kyleburnsdev/icom-ctcss-board/firmware/README.md

# Arduino firmware

Firmware implementation has not started. The authoritative behavior draft is the [firmware specification](../docs/requirements/firmware-specification.md).

Create the Arduino sketch as `icom_ctcss/icom_ctcss.ino` so the sketch and folder names match. Document the board package, exact board selection, library versions, build and upload commands here when implemented. The target module is a 5 V / 16 MHz ATmega32U4 Pro Micro; the PCB pin assignments are fixed constraints.
