kyleburnsdev/icom-ctcss-board/mechanical/enclosure/README.md

# Enclosure

Open [icom-ctcss-enclosure.FCStd](icom-ctcss-enclosure.FCStd) in FreeCAD 1.1.1. P1 uses native Part Design bodies, constrained Sketcher profiles, Draft lettering and a Spreadsheet; no third-party workbench is required.

- [P1 design, views and verification](../../docs/implementation/enclosure-p1.md)
- [Primary 3MF build and assembly instructions](../../manufacturing/enclosure/README.md)
- [Requirements](../../docs/requirements/enclosure-specification.md)
- [Decision and prototype register](../../docs/requirements/enclosure-decision-register.md)
- [Reproducible builder](../../tools/build-enclosure.py)

The saved model retains installation coordinates. Print-oriented meshes are supporting assets beneath the primary build. `revisions/p01-enclosure.FCStd` preserves the previous native baseline.
