kyleburnsdev/icom-ctcss-board/manufacturing/pcb/digikey-board-parts.csv

DigiKey Part Number | Quantity | Customer Reference | Manufacturer Part Number | Manufacturer | Description
BC1084CT-ND | 4 | C1, C2, C4, C5 | K104K15X7RF5TL2 | Vishay | 100nF; 100nF 50V X7R 10%
399-5860-ND | 1 | C3 | R82DC4100AA60J | KEMET | 1uF 63V FILM; Nonpolar 1uF 63V 5%
495-1131-ND | 1 | C6 | B32522C0475J000 | TDK | 4.7uF 63V FILM; Nonpolar 4.7uF 63V 5%
732-5321-ND | 2 | J1, J2 | 61300811121 | Wurth Elektronik | 1x8 straight male header; 2.54 mm pitch
732-5318-ND | 1 | J3 | 61300511121 | Wurth Elektronik | 1x5 straight male header; 2.54 mm pitch
732-5317-ND | 2 | J4, J6 | 61300411121 | Wurth Elektronik | 1x4 straight male header; 2.54 mm pitch
732-5315-ND | 1 | J5 | 61300211121 | Wurth Elektronik | 1x2 straight male header; 2.54 mm pitch
2N3904TARCT-ND | 1 | Q1 | 2N3904TAR | onsemi | 2N3904TAR; Factory-formed CASE135AR
BC3934CT-ND | 2 | R1, R2 | MRS16000C3301FCT00 | Vishay | 3.3k; 1% metal film
BC3918CT-ND | 6 | R3, R9, R12, R13, R14, R15 | MRS16000C1002FCT00 | Vishay | 10k; 1% metal film
BC3915CT-ND | 2 | R4, R8 | MRS16000C1001FCT00 | Vishay | 1k; 1% metal film
BC3921CT-ND | 2 | R5, R11 | MRS16000C1003FCT00 | Vishay | 100k; 1% metal film
BC3933CT-ND | 2 | R6, R7 | MRS16000C3300FCT00 | Vishay | 330; 1% metal film
BC3940CT-ND | 1 | R10 | MRS16000C4701FCT00 | Vishay | 4.7k; 1% metal film
3296W-103LF-ND | 1 | RV1 | 3296W-1-103LF | Bourns | 10k 3296W; CW increases tone
732-5314-ND | 8 | TP1, TP2, TP3, TP4, TP5, TP6, TP7, TP8 | 61300111121 | Wurth Elektronik | Single 2.54 mm test post
732-61301211821-ND | 2 | U1 socket strips | 61301211821 | Wurth Elektronik | 1x12 female socket; 2.54 mm pitch; 2.5 mm body width; 8.5 mm insulator height
