kyleburnsdev/icom-ctcss-board/manufacturing/enclosure/supporting/revisions/p01/step/p0-enclosure-assembly.step

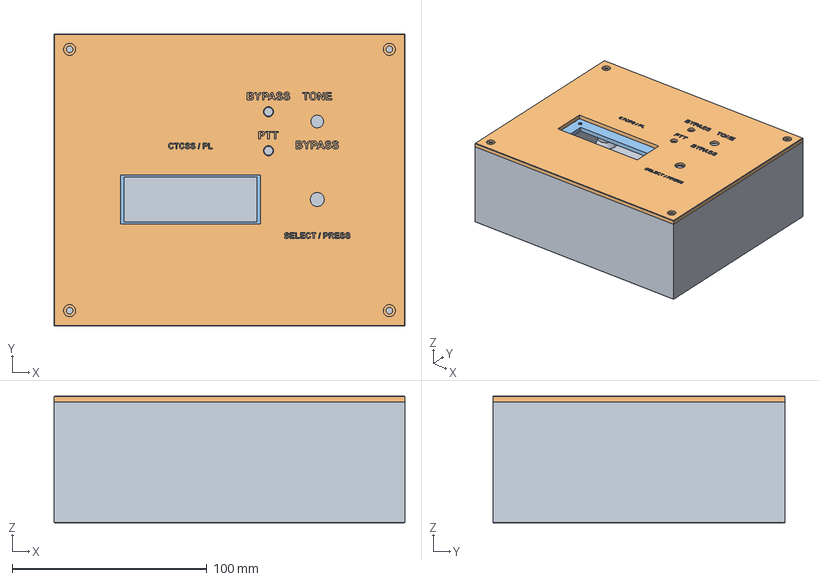
[picture p3: CAD file, 2026-10-22]
manufacturing/enclosure/supporting/revisions/p01/step/p0-enclosure-assembly.step
180.0 x 150.0 x 65.0 mm
P0 base â€” floor down001
P0 operator lid â€” exterior down001
LCD cradle001
LED keeper 001
LED keeper 002
