kyleburnsdev/icom-ctcss-board/manufacturing/enclosure/supporting/step/p1-enclosure-assembly.step

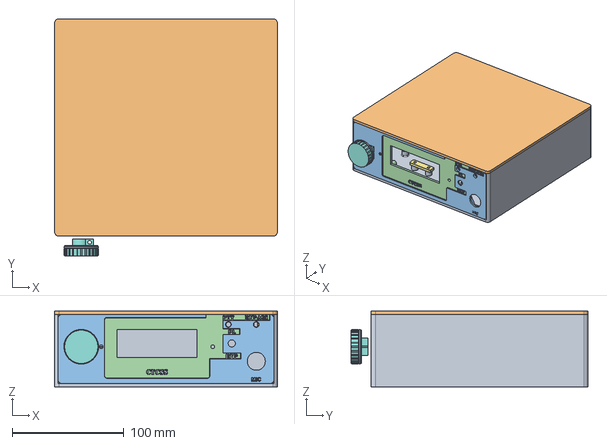
[picture p4: CAD file, 2026-10-22]
manufacturing/enclosure/supporting/step/p1-enclosure-assembly.step
200.0 x 213.0 x 68.0 mm
