kyleburnsdev/icom-ctcss-board/manufacturing/enclosure/p1-enclosure.3mf

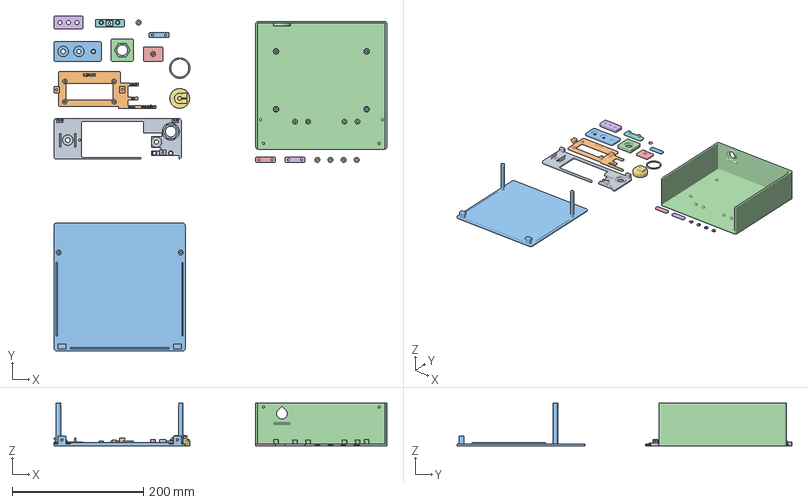
[picture p5: CAD file, 2026-10-22]
manufacturing/enclosure/p1-enclosure.3mf
507.2 x 510.2 x 65.0 mm
fascia_1
displayinsert_1
controlcoupon_1
gxcoupon_1
mountcoupon_1
shaftcoupon_1
encoderknob_1
ledkeeper_1
knobaccentring_1
pcbwasher-fit_1
wirekeeper-fit_1
base_1
wirekeeper-a_1
wirekeeper-b_1
pcbwasher-a_1
pcbwasher-b_1
pcbwasher-c_1
pcbwasher-d_1
cover_1
