kyleburnsdev/icom-ctcss-board/manufacturing/enclosure/supporting/revisions/p01/p01-enclosure.3mf

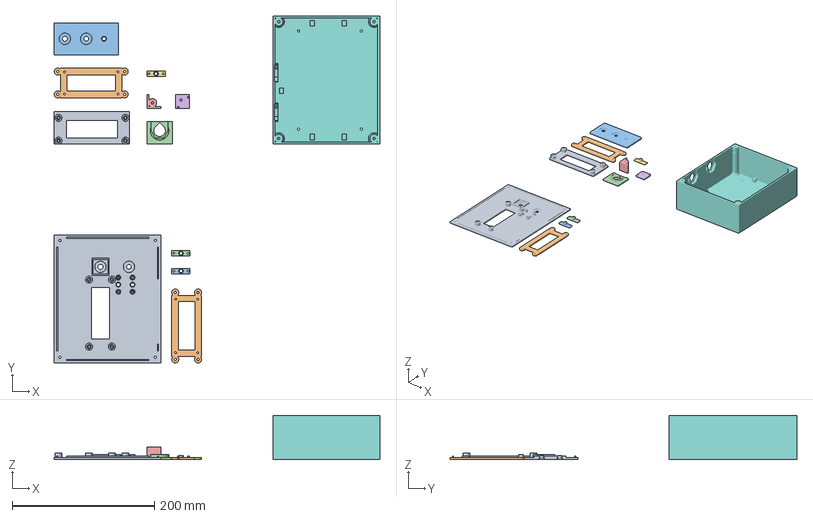
[picture p6: CAD file, 2026-10-22]
manufacturing/enclosure/supporting/revisions/p01/p01-enclosure.3mf
457.2 x 487.2 x 62.0 mm
lcdcoupon_1
lcdcradle_1 x 2
controlcoupon_1
gxcoupon_1
jointbasecoupon_1
jointlidcoupon_1
ledkeeper1_1 x 2
base_1
lid_1
ledkeeper2_1
