kyleburnsdev/icom-ctcss-board/manufacturing/enclosure/supporting/revisions/p01/stl/p0-lid.stl

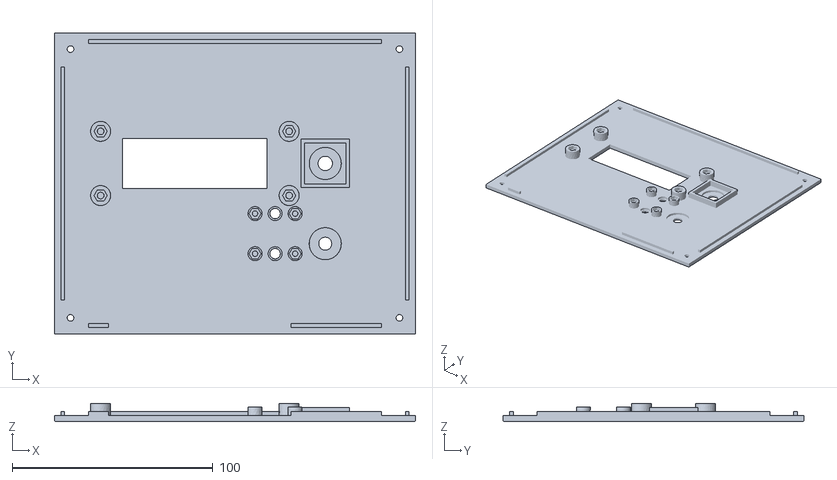
[picture p7: CAD file, 2026-10-22]
manufacturing/enclosure/supporting/revisions/p01/stl/p0-lid.stl
180.0 x 150.0 x 9.00
