kyleburnsdev/icom-ctcss-board/manufacturing/enclosure/supporting/stl/p1-wirekeeper.stl

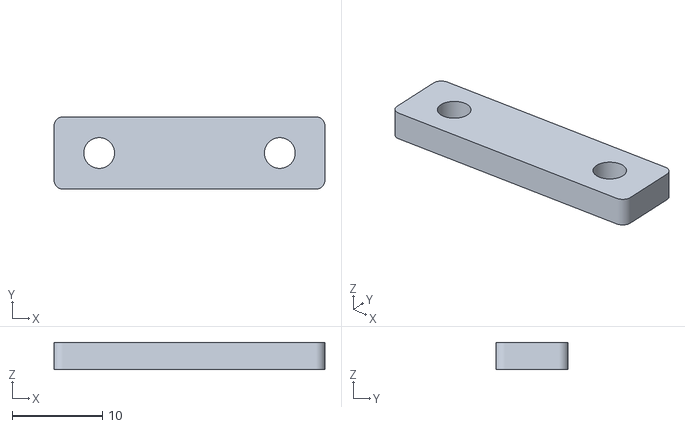
[picture p8: CAD file, 2026-10-22]
manufacturing/enclosure/supporting/stl/p1-wirekeeper.stl
30.0 x 8.00 x 3.00
