kyleburnsdev/icom-ctcss-board/mechanical/enclosure/icom-ctcss-enclosure.FCStd

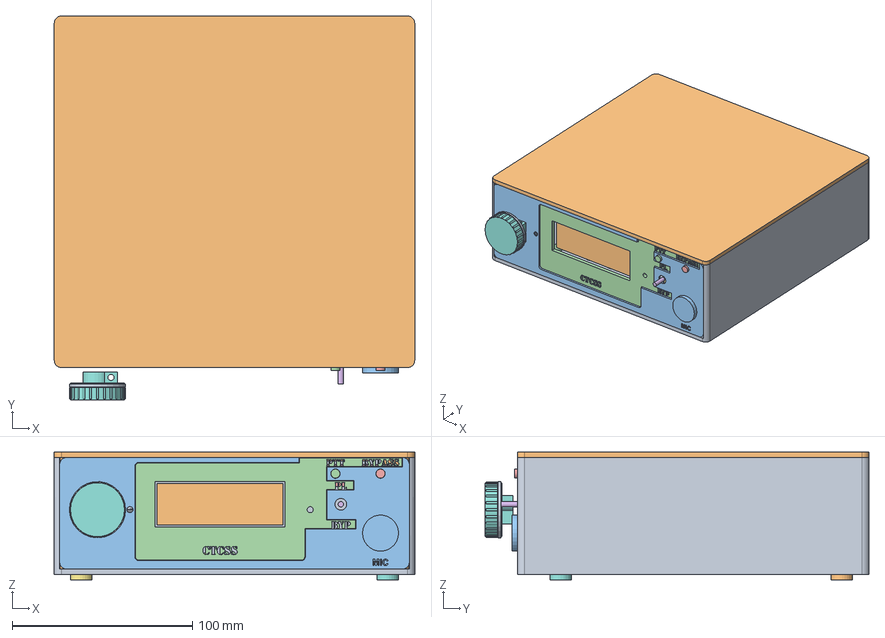
[picture p9: CAD file, 2026-10-22]
mechanical/enclosure/icom-ctcss-enclosure.FCStd
200.0 x 213.0 x 71.0 mm
Base
Cover
Fascia
DisplayInsert
LedKeeper
PcbWasher x 4
WireKeeper x 2
EncoderKnob
KnobAccentRing
VisibleLcdGlass
MicShell
PttLens
BypassLens
BypassLever
CompliantFoot1
CompliantFoot2
CompliantFoot3
CompliantFoot4
