kyleburnsdev/icom-ctcss-board/mechanical/enclosure/revisions/p01-enclosure.FCStd

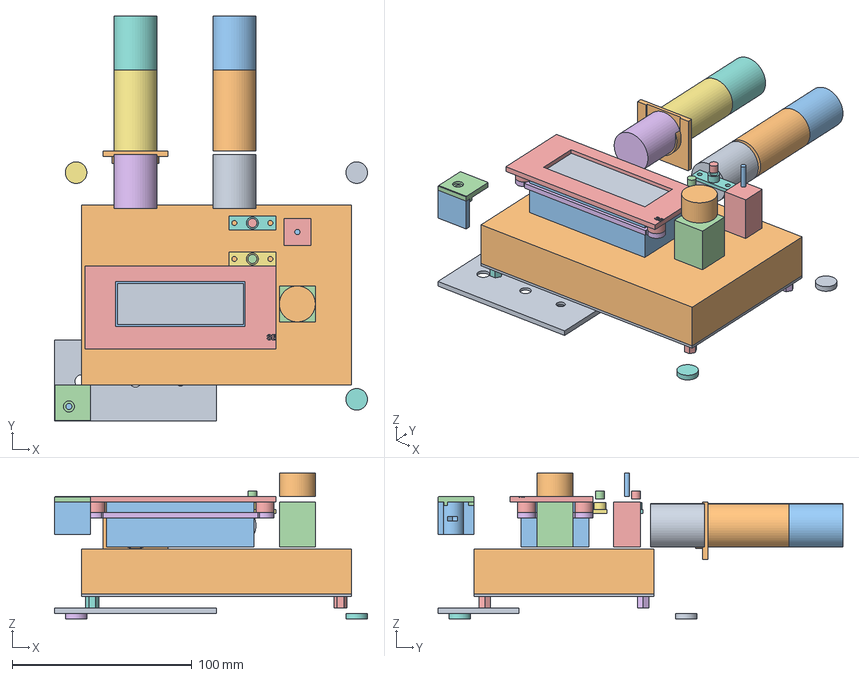
[picture p10: CAD file, 2026-10-22]
mechanical/enclosure/revisions/p01-enclosure.FCStd
174.0 x 225.0 x 81.0 mm
ControlCoupon001
GXCoupon001
JointBaseCoupon001
JointLidCoupon001
LCDCoupon001
LCD cradle001
LED keeper 001
LED keeper 002
Carrier PCB â€” existing hole pattern
Populated carrier allocation
LCD/backpack allocation
EC11 allocation
Toggle allocation
GX16 internal termination allocation
GX16 mating plug envelope
GX16 cable bend allocation
GX16 internal termination allocation001
GX16 mating plug envelope001
GX16 cable bend allocation001
Socketed Pro Micro module
Purchased insulating standoff
Purchased insulating standoff001
Purchased insulating standoff002
Purchased insulating standoff003
LCD viewing surface
Encoder knob
Bypass lever
5 mm indicator lens
5 mm indicator lens001
Nonslip foot
Nonslip foot001
Nonslip foot002
Nonslip foot003
