kyleburnsdev/icom-ctcss-board/mechanical/pcb/icom-ctcss-pcb-cam.FCStd

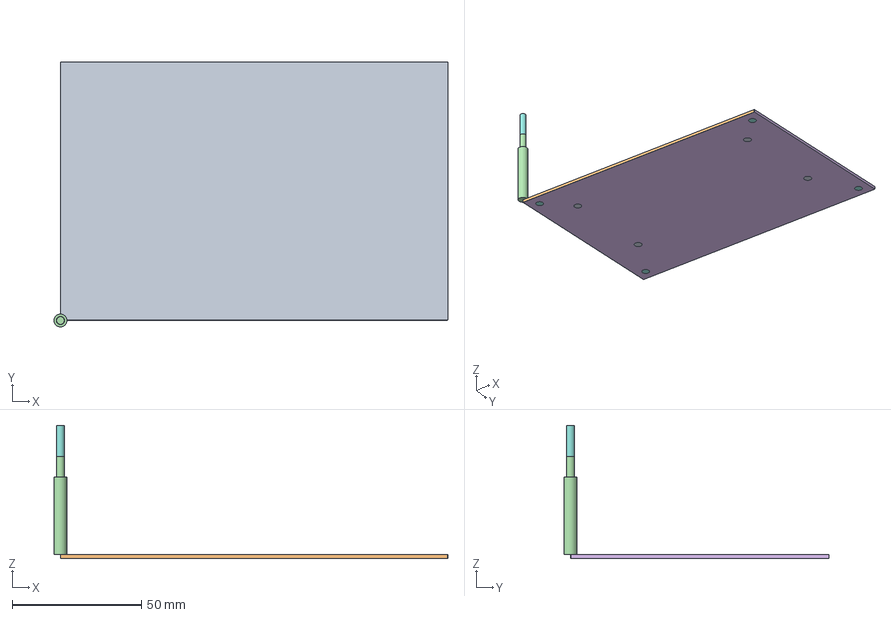
[picture p11: CAD file, 2026-10-31]
mechanical/pcb/icom-ctcss-pcb-cam.FCStd
152.6 x 102.6 x 51.7 mm
Endmill001
Endmill006
Endmill009
Endmill018
Endmill021
Model-Job00_RegistrationPreparation | 150 x 100 x 1.5 mm blank, top Z0
Model-Job10_BottomCopper | 150 x 100 x 1.5 mm blank, top Z0
Model-Job30_BottomHoles | 150 x 100 x 1.5 mm blank, top Z0
Model-Job40_TopLegend | 150 x 100 x 1.5 mm blank, top Z0
Model-Job20_BottomMaskRemoval | 150 x 100 x 1.5 mm blank, top Z0
T3 Corn 0.8 mm
T3 Corn 0.8 | 0.9 mm bore feed
T3 Corn 0.8 | 1.1 mm bore feed
T3 Corn 0.8 | enclosure mounts
Laser focus placeholder | no spindle post
PocketFourEnclosureMounts_Floors
PrepareFourJigHoles_Floors
Stock
Stock001
Stock002
Stock003
Stock004
T2 V-bit 30 deg tip 0.2 mm
T4 Makera spring solder-mask remover | 0.3 mm 30 deg
