kyleburnsdev/icom-ctcss-board/manufacturing/enclosure/supporting/revisions/p01/stl/p0-lcdcradle.stl

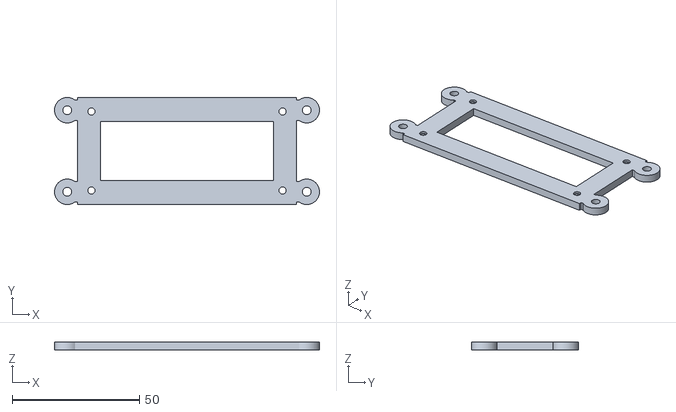
[picture p12: CAD file, 2026-10-22]
manufacturing/enclosure/supporting/revisions/p01/stl/p0-lcdcradle.stl
104.0 x 42.0 x 3.00
