kyleburnsdev/icom-ctcss-board/manufacturing/enclosure/supporting/stl/p1-controlcoupon.stl

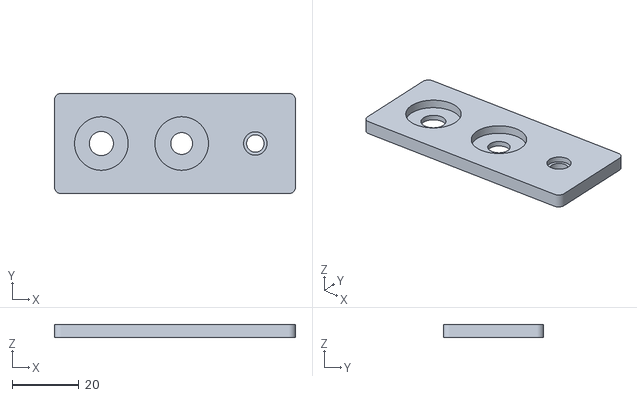
[picture p13: CAD file, 2026-10-22]
manufacturing/enclosure/supporting/stl/p1-controlcoupon.stl
72.0 x 30.0 x 4.00
