kyleburnsdev/icom-ctcss-board/manufacturing/enclosure/supporting/revisions/p01/stl/p0-ledkeeper2.stl

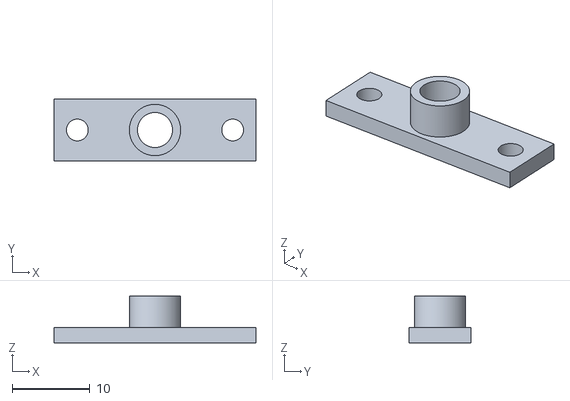
[picture p14: CAD file, 2026-10-22]
manufacturing/enclosure/supporting/revisions/p01/stl/p0-ledkeeper2.stl
26.0 x 8.00 x 6.00
