kyleburnsdev/icom-ctcss-board/manufacturing/enclosure/supporting/stl/p1-base.stl

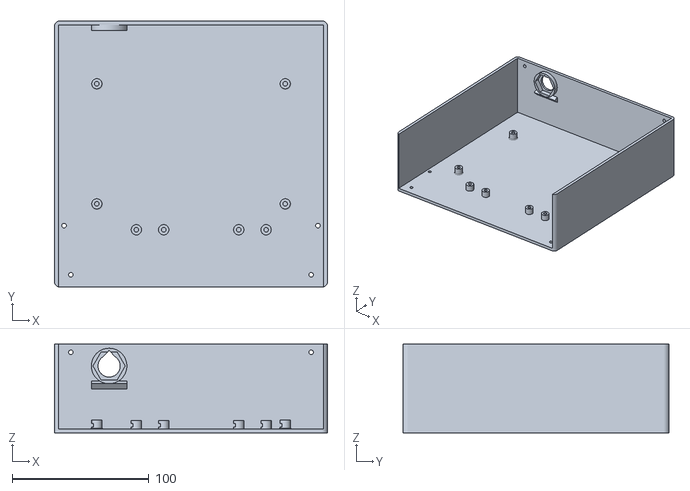
[picture p15: CAD file, 2026-10-22]
manufacturing/enclosure/supporting/stl/p1-base.stl
200.0 x 195.0 x 65.0
