kyleburnsdev/icom-ctcss-board/manufacturing/enclosure/supporting/revisions/p01/stl/p0-jointlidcoupon.stl

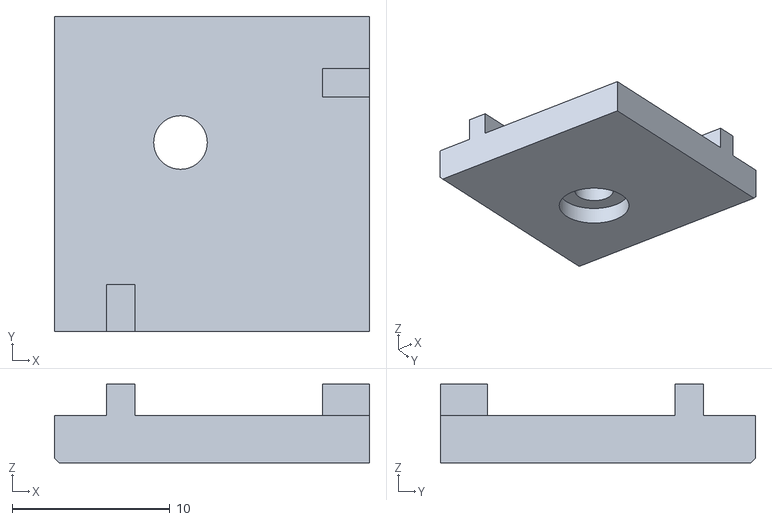
[picture p16: CAD file, 2026-10-22]
manufacturing/enclosure/supporting/revisions/p01/stl/p0-jointlidcoupon.stl
20.0 x 20.0 x 5.00
