kyleburnsdev/icom-ctcss-board/manufacturing/enclosure/supporting/stl/p1-displayinsert.stl

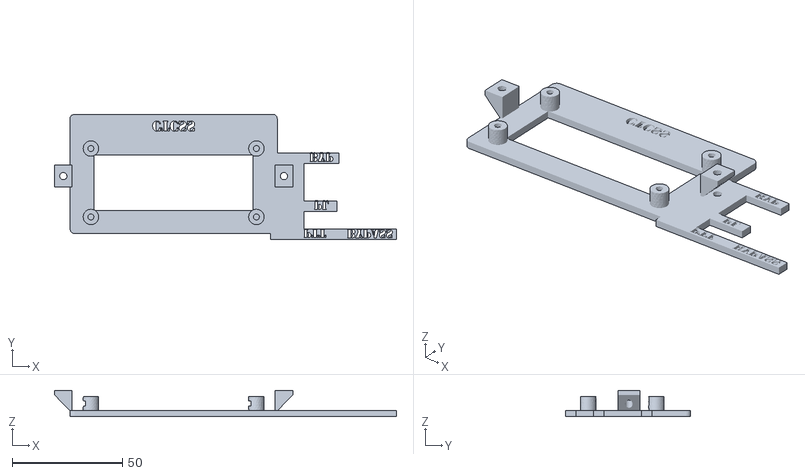
[picture p17: CAD file, 2026-10-22]
manufacturing/enclosure/supporting/stl/p1-displayinsert.stl
155.0 x 56.8 x 11.8
