kyleburnsdev/icom-ctcss-board/manufacturing/enclosure/supporting/revisions/p01/stl/p0-jointbasecoupon.stl

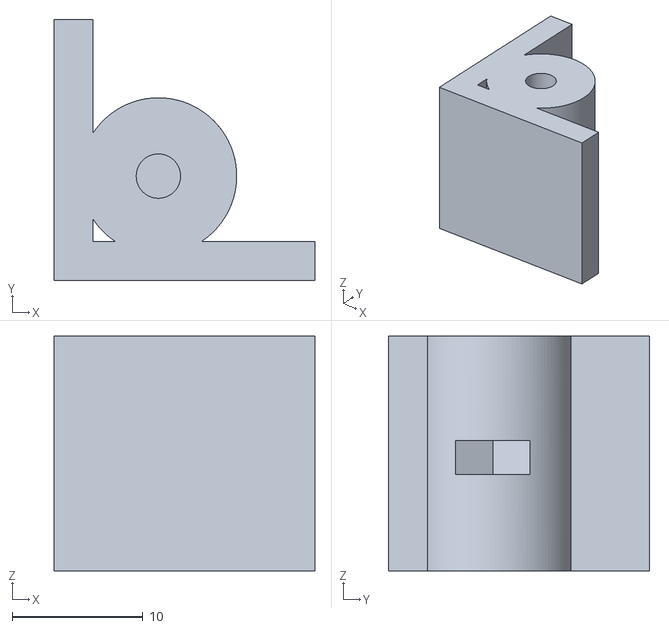
[picture p18: CAD file, 2026-10-22]
manufacturing/enclosure/supporting/revisions/p01/stl/p0-jointbasecoupon.stl
20.0 x 20.0 x 18.0
