kyleburnsdev/icom-ctcss-board/manufacturing/enclosure/supporting/stl/p1-fascia.stl

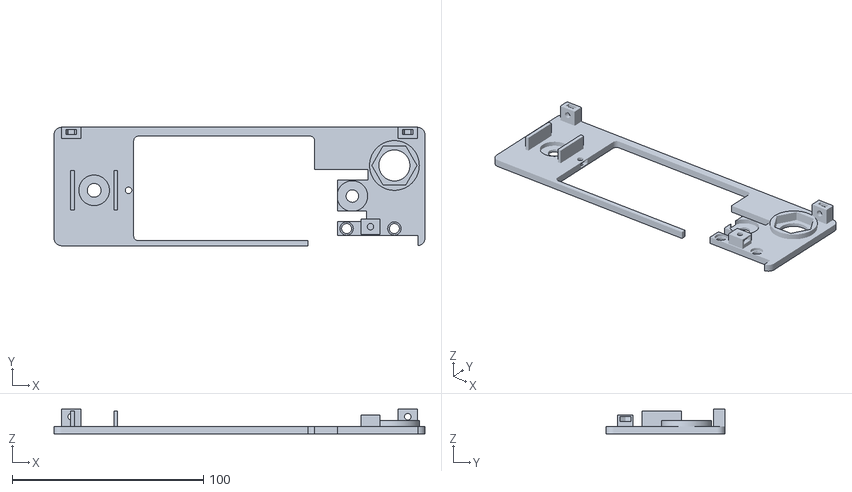
[picture p19: CAD file, 2026-10-22]
manufacturing/enclosure/supporting/stl/p1-fascia.stl
194.0 x 62.0 x 13.0
