kyleburnsdev/icom-ctcss-board/manufacturing/enclosure/supporting/revisions/p01/stl/p0-gxcoupon.stl

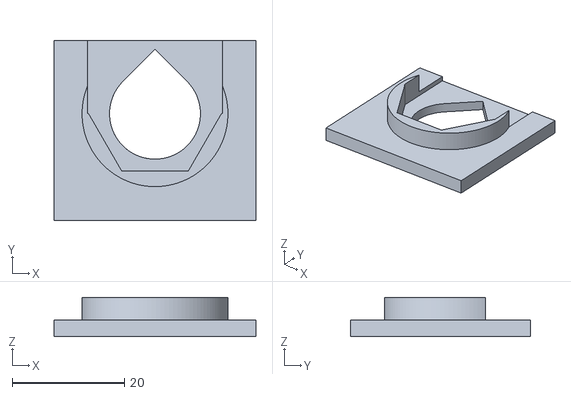
[picture p20: CAD file, 2026-10-22]
manufacturing/enclosure/supporting/revisions/p01/stl/p0-gxcoupon.stl
36.0 x 32.0 x 7.00
