kyleburnsdev/icom-ctcss-board/manufacturing/enclosure/supporting/stl/p1-knobaccentring.stl

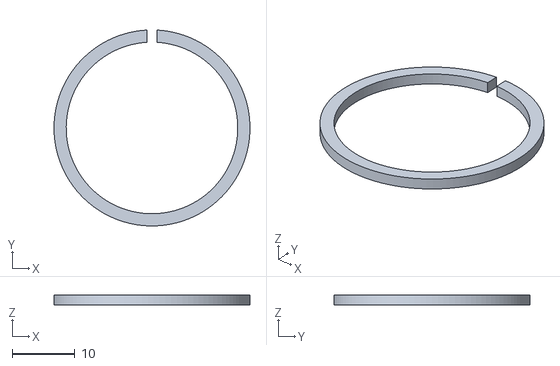
[picture p21: CAD file, 2026-10-22]
manufacturing/enclosure/supporting/stl/p1-knobaccentring.stl
31.2 x 31.2 x 1.60
