kyleburnsdev/icom-ctcss-board/manufacturing/enclosure/supporting/stl/p1-shaftcoupon.stl

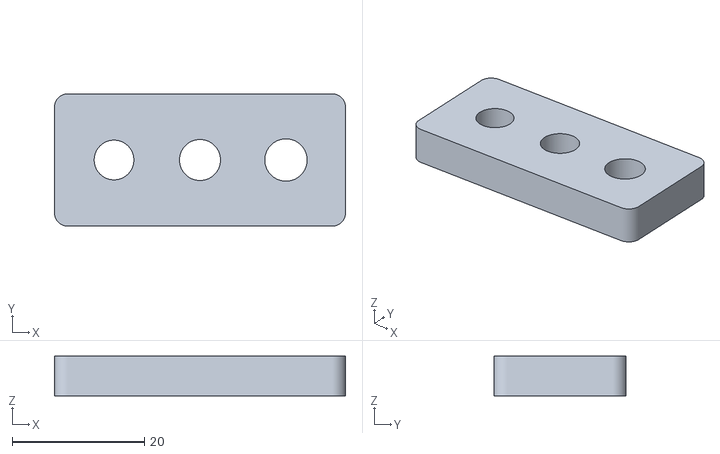
[picture p22: CAD file, 2026-10-22]
manufacturing/enclosure/supporting/stl/p1-shaftcoupon.stl
44.0 x 20.0 x 6.00
