kyleburnsdev/icom-ctcss-board/manufacturing/enclosure/supporting/revisions/p01/stl/p0-lcdcoupon.stl

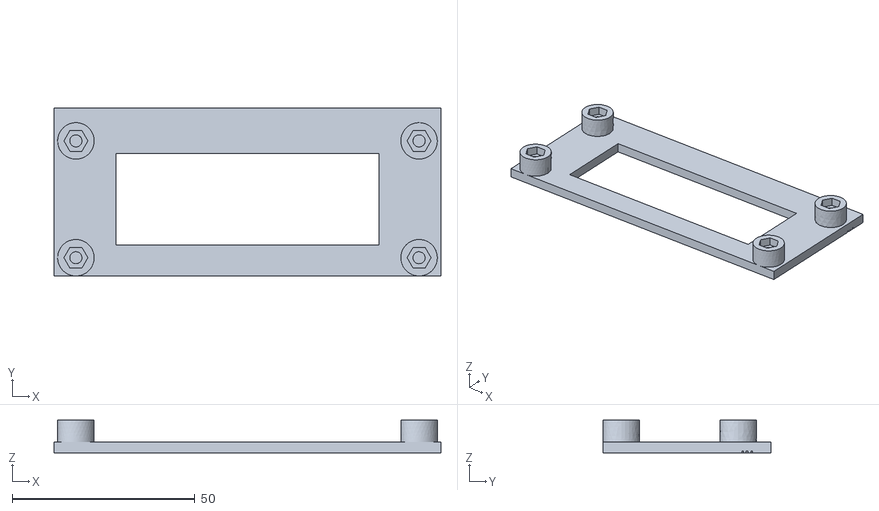
[picture p23: CAD file, 2026-10-22]
manufacturing/enclosure/supporting/revisions/p01/stl/p0-lcdcoupon.stl
106.0 x 46.0 x 9.00
