kyleburnsdev/icom-ctcss-board/manufacturing/enclosure/supporting/stl/p1-gxcoupon.stl

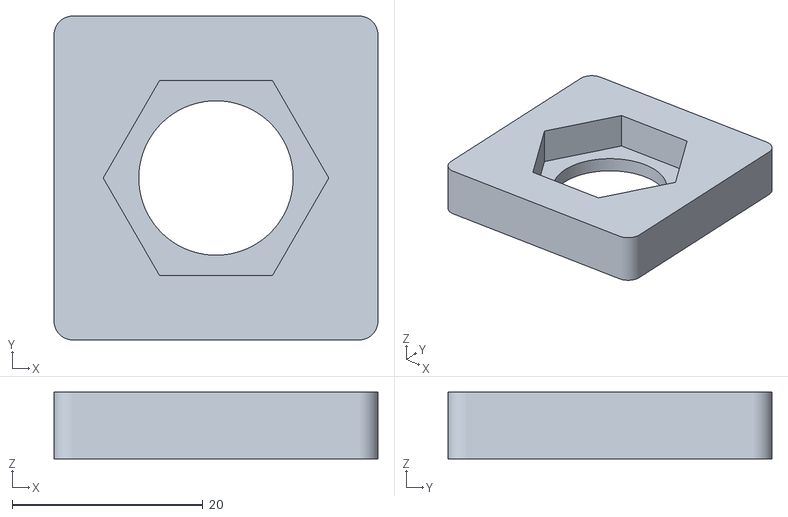
[picture p24: CAD file, 2026-10-22]
manufacturing/enclosure/supporting/stl/p1-gxcoupon.stl
34.0 x 34.0 x 7.00
