kyleburnsdev/icom-ctcss-board/manufacturing/enclosure/supporting/revisions/p01/stl/p0-controlcoupon.stl

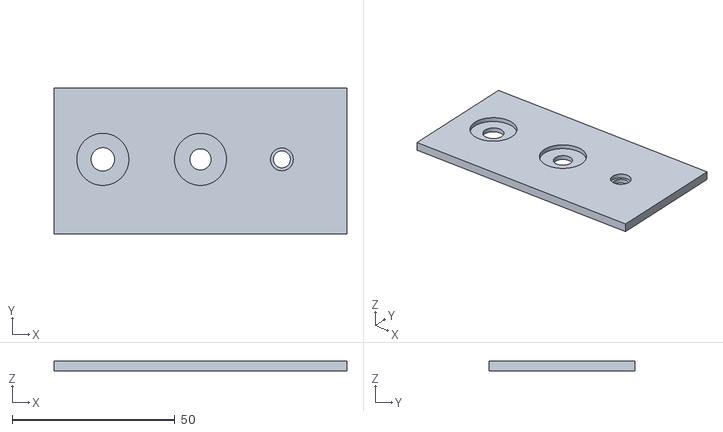
[picture p25: CAD file, 2026-10-22]
manufacturing/enclosure/supporting/revisions/p01/stl/p0-controlcoupon.stl
90.0 x 45.0 x 3.00
