kyleburnsdev/icom-ctcss-board/manufacturing/enclosure/supporting/stl/p1-encoderknob.stl

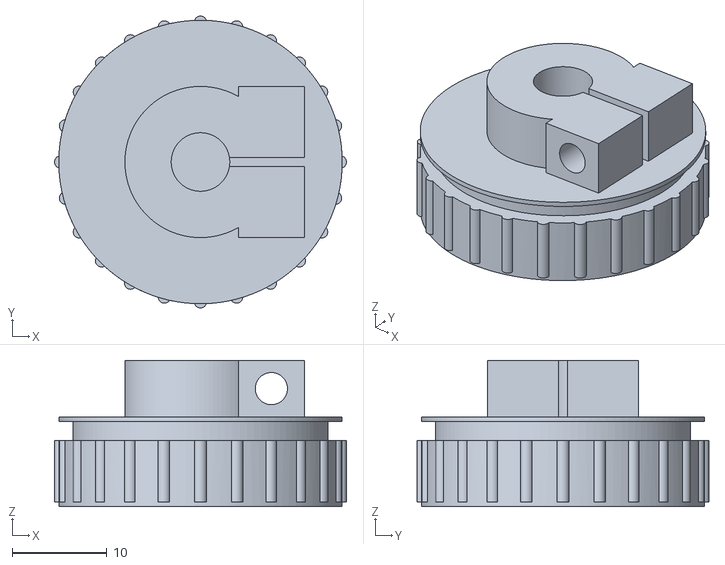
[picture p26: CAD file, 2026-10-22]
manufacturing/enclosure/supporting/stl/p1-encoderknob.stl
30.9 x 30.9 x 15.5
