kyleburnsdev/icom-ctcss-board/manufacturing/enclosure/supporting/revisions/p01/stl/p0-base.stl

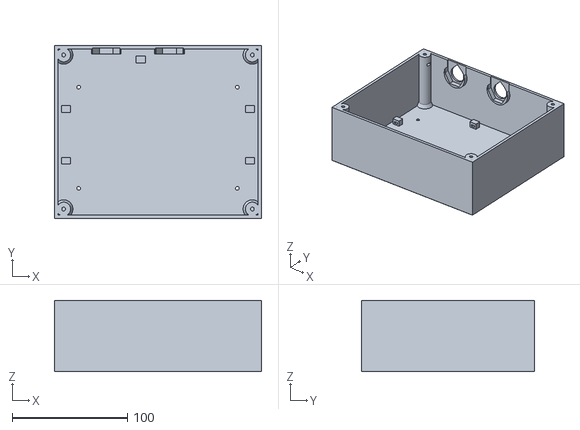
[picture p27: CAD file, 2026-10-22]
manufacturing/enclosure/supporting/revisions/p01/stl/p0-base.stl
180.0 x 150.0 x 62.0
