kyleburnsdev/icom-ctcss-board/manufacturing/enclosure/supporting/stl/p1-mountcoupon.stl

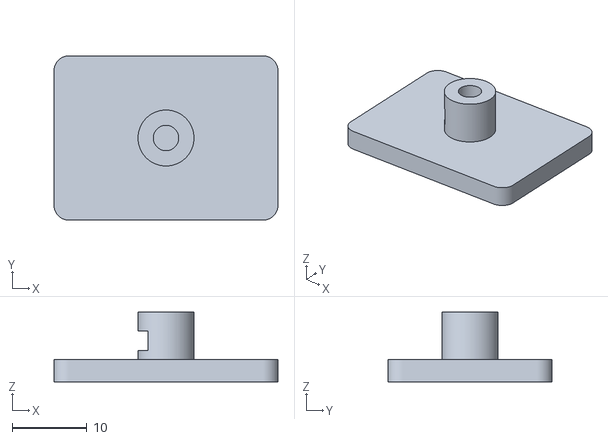
[picture p28: CAD file, 2026-10-22]
manufacturing/enclosure/supporting/stl/p1-mountcoupon.stl
30.0 x 22.0 x 9.35
