kyleburnsdev/icom-ctcss-board/manufacturing/enclosure/supporting/stl/p1-ledkeeper.stl

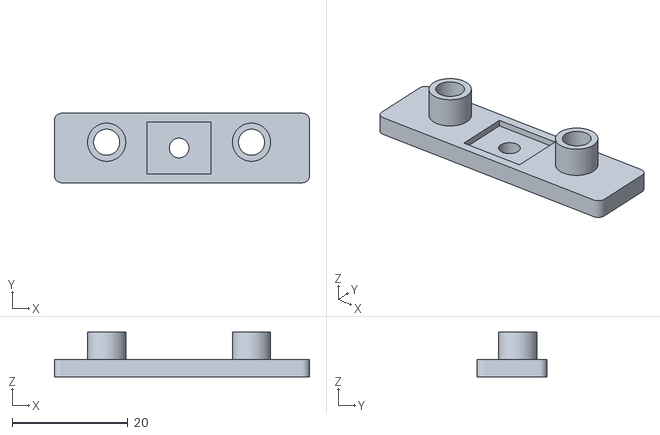
[picture p29: CAD file, 2026-10-22]
manufacturing/enclosure/supporting/stl/p1-ledkeeper.stl
44.0 x 12.0 x 7.70
