kyleburnsdev/icom-ctcss-board/(list of files, cad)

Other CAD files:
manufacturing/enclosure/supporting/stl/p1-pcbwasher.stl
