kyleburnsdev/icom-ctcss-board/docs/verification/enclosure-p0/assembled.png

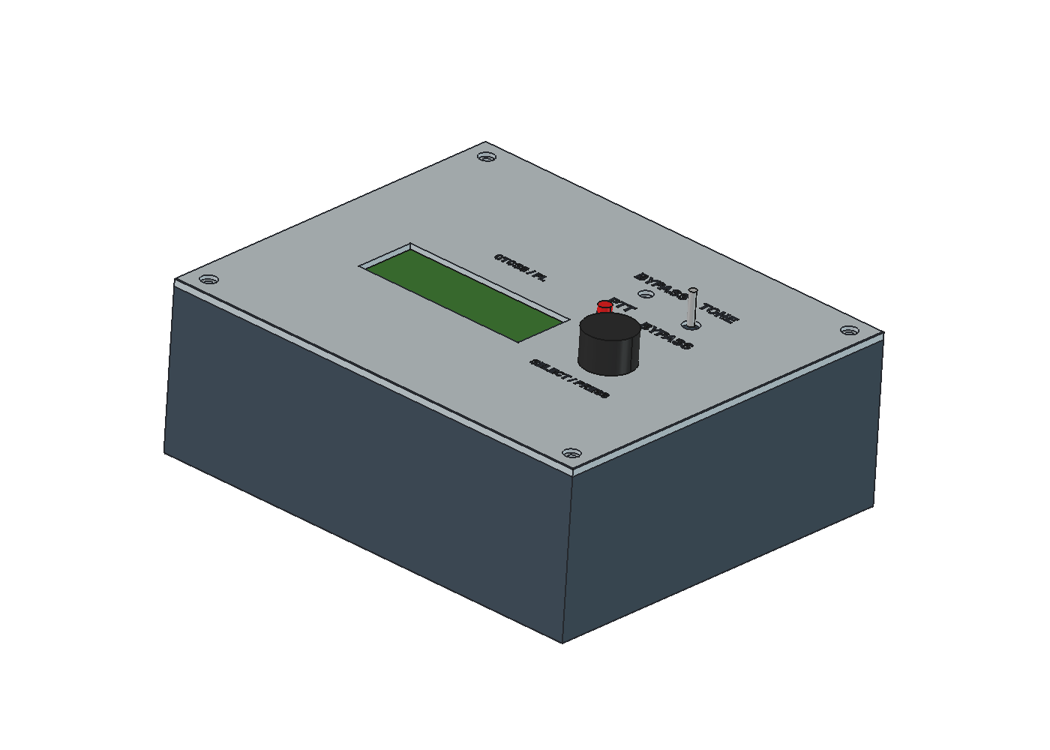
docs/verification/enclosure-p0/assembled.png
