kyleburnsdev/icom-ctcss-board/docs/verification/enclosure-p0/print-plate-1.png

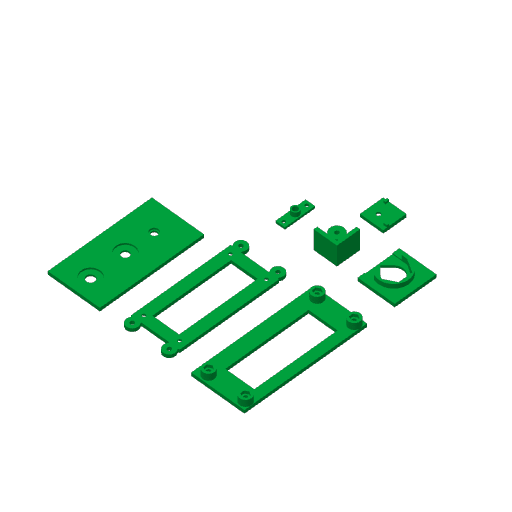
docs/verification/enclosure-p0/print-plate-1.png
