kyleburnsdev/icom-ctcss-board/docs/verification/enclosure-p0/print-plate-2.png

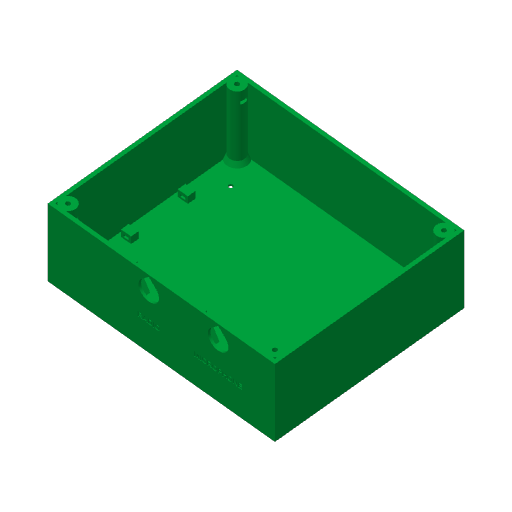
docs/verification/enclosure-p0/print-plate-2.png
