kyleburnsdev/icom-ctcss-board/docs/verification/enclosure-p0/print-plate-3.png

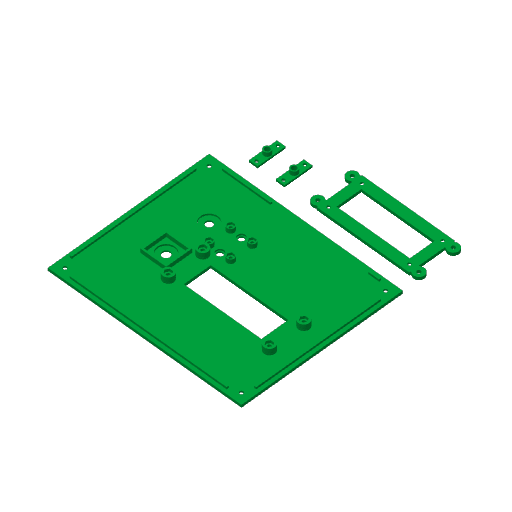
docs/verification/enclosure-p0/print-plate-3.png
