kyleburnsdev/icom-ctcss-board/docs/verification/enclosure-p1/print-plate-1.png

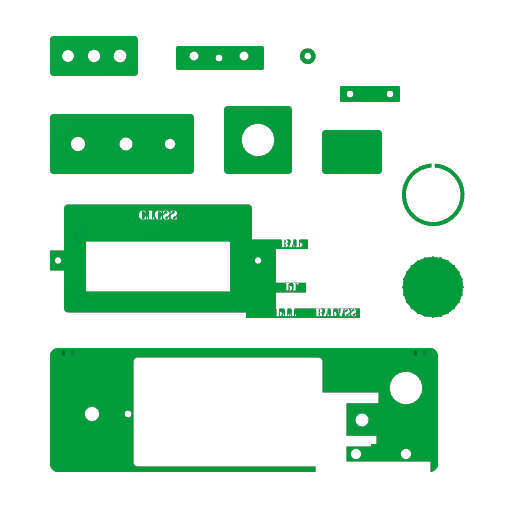
docs/verification/enclosure-p1/print-plate-1.png
