kyleburnsdev/icom-ctcss-board/docs/verification/enclosure-p1/print-plate-2.png

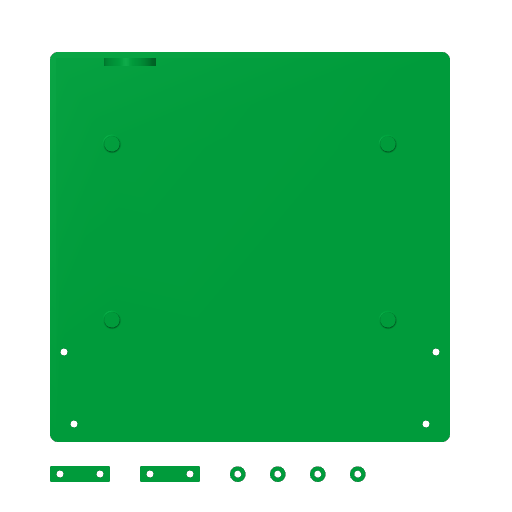
docs/verification/enclosure-p1/print-plate-2.png
