kyleburnsdev/icom-ctcss-board/docs/verification/enclosure-p1/print-plate-3.png

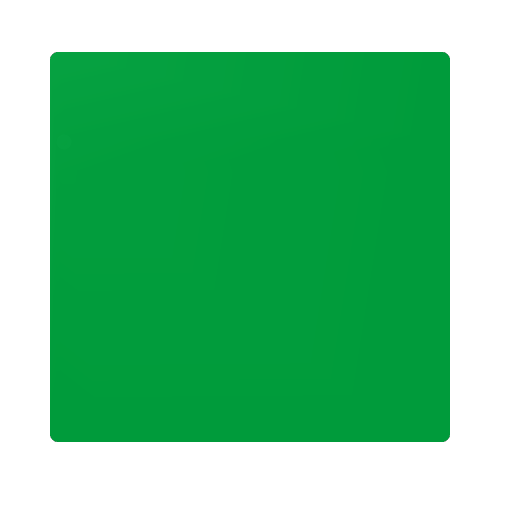
docs/verification/enclosure-p1/print-plate-3.png
