kyleburnsdev/icom-ctcss-board/docs/verification/ltspice/nominal-ac.csv

step | rl | w | frequency_hz | gain_v_v
0 | 600.0 | 0.0 | 67.0 | 3.0100451727419406e-11
0 | 600.0 | 0.0 | 69.3 | 3.004357380121755e-11
0 | 600.0 | 0.0 | 71.9 | 2.997726966332207e-11
0 | 600.0 | 0.0 | 74.4 | 2.9911552618110836e-11
0 | 600.0 | 0.0 | 77.0 | 2.98412142001633e-11
0 | 600.0 | 0.0 | 79.7 | 2.976607283787097e-11
0 | 600.0 | 0.0 | 82.5 | 2.96859496702506e-11
0 | 600.0 | 0.0 | 85.4 | 2.960066968820385e-11
0 | 600.0 | 0.0 | 88.5 | 2.950700176299359e-11
0 | 600.0 | 0.0 | 91.5 | 2.941396562448626e-11
0 | 600.0 | 0.0 | 94.8 | 2.9309001348233e-11
0 | 600.0 | 0.0 | 97.4 | 2.922442871639314e-11
0 | 600.0 | 0.0 | 100.0 | 2.9138257779323565e-11
0 | 600.0 | 0.0 | 103.5 | 2.9019819786411112e-11
0 | 600.0 | 0.0 | 107.2 | 2.8891690481171282e-11
0 | 600.0 | 0.0 | 110.9 | 2.8760692462016857e-11
0 | 600.0 | 0.0 | 114.8 | 2.861965952567226e-11
0 | 600.0 | 0.0 | 118.8 | 2.847202560855794e-11
0 | 600.0 | 0.0 | 123.0 | 2.8313942155883338e-11
0 | 600.0 | 0.0 | 127.3 | 2.814903952699681e-11
0 | 600.0 | 0.0 | 131.8 | 2.7973379370421502e-11
0 | 600.0 | 0.0 | 136.5 | 2.7786788637329484e-11
0 | 600.0 | 0.0 | 141.3 | 2.7593199636748142e-11
0 | 600.0 | 0.0 | 146.2 | 2.7392699264848898e-11
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
