kyleburnsdev/icom-ctcss-board/docs/verification/ltspice/tolerance-corners.csv

step | k | rl | frequency_hz | gain_v_v
0 | 0.0 | 600.0 | 67.0 | 0.00030058767964736925
0 | 0.0 | 600.0 | 151.4 | 0.00027657856164195997
0 | 0.0 | 600.0 | 254.1 | 0.0002374709044102643
0 | 0.0 | 600.0 | 10000.0 | 1.4307465135032813e-06
1 | 1.0 | 600.0 | 67.0 | 0.00029929982723585127
1 | 1.0 | 600.0 | 151.4 | 0.00027493996010742307
1 | 1.0 | 600.0 | 254.1 | 0.00023549584871563868
1 | 1.0 | 600.0 | 10000.0 | 1.4025737614305355e-06
2 | 2.0 | 600.0 | 67.0 | 0.00029941361440384405
2 | 2.0 | 600.0 | 151.4 | 0.000275390967571534
2 | 2.0 | 600.0 | 254.1 | 0.00023629620619851425
2 | 2.0 | 600.0 | 10000.0 | 1.4028343731459618e-06
3 | 3.0 | 600.0 | 67.0 | 0.0002981354120114723
3 | 3.0 | 600.0 | 151.4 | 0.0002737648441917596
3 | 3.0 | 600.0 | 254.1 | 0.00023433742400199063
3 | 3.0 | 600.0 | 10000.0 | 1.3752097696494593e-06
4 | 4.0 | 600.0 | 67.0 | 0.0002970778567686236
4 | 4.0 | 600.0 | 151.4 | 0.0002731080067849395
4 | 4.0 | 600.0 | 254.1 | 0.00023419120152270217
4 | 4.0 | 600.0 | 10000.0 | 1.4047240663461863e-06
5 | 5.0 | 600.0 | 67.0 | 0.0002958157523148991
5 | 5.0 | 600.0 | 151.4 | 0.0002714943124206887
5 | 5.0 | 600.0 | 254.1 | 0.00023224269902581246
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
