kyleburnsdev/icom-ctcss-board/docs/verification/enclosure-p0/base-interior.png

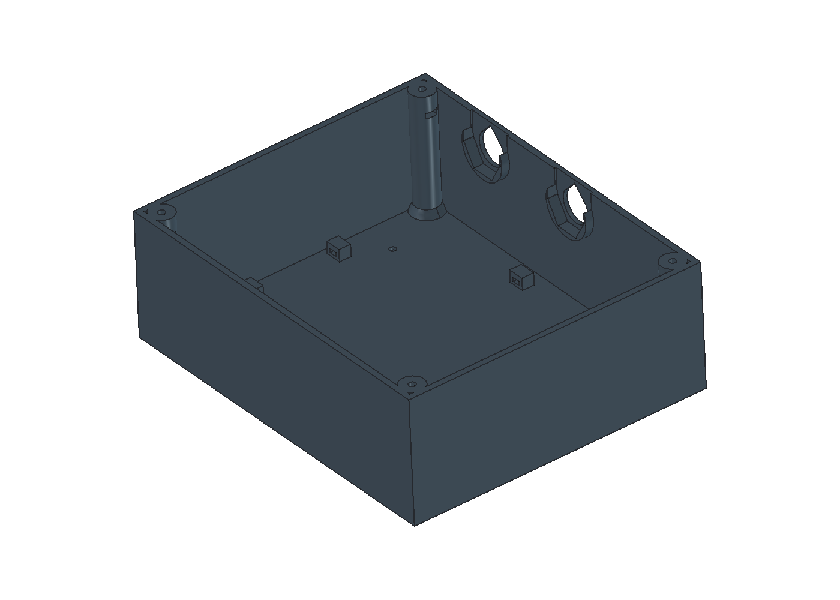
docs/verification/enclosure-p0/base-interior.png
