kyleburnsdev/icom-ctcss-board/docs/verification/enclosure-p0/lid-underside.png

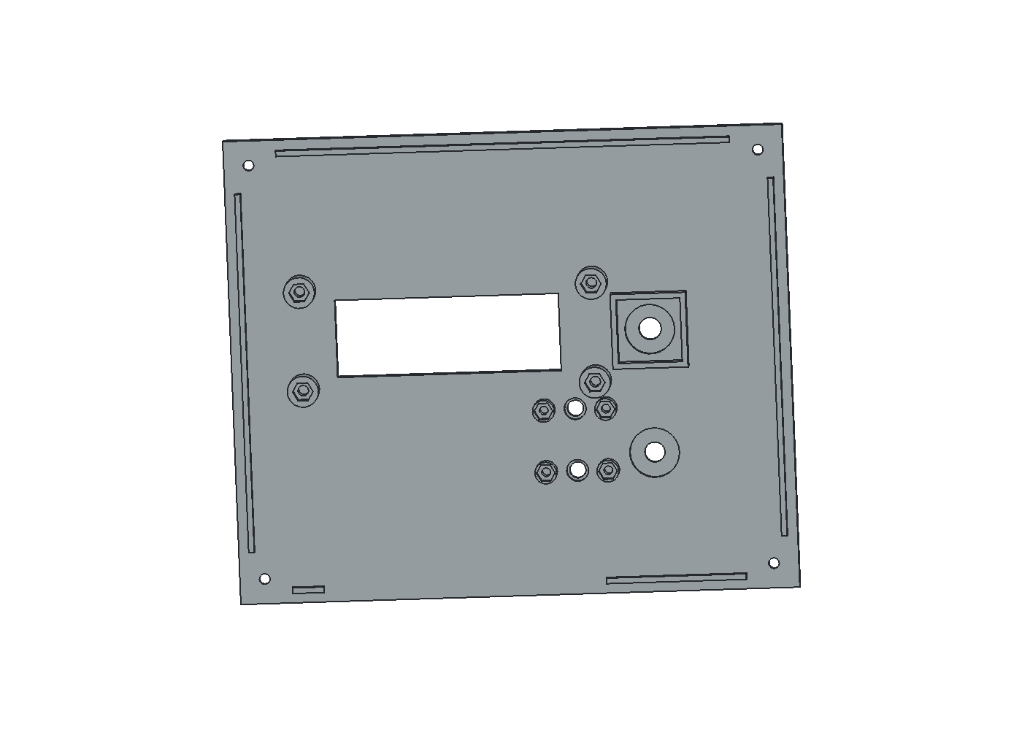
docs/verification/enclosure-p0/lid-underside.png
