kyleburnsdev/icom-ctcss-board/docs/verification/enclosure-p0/rear-labels.png

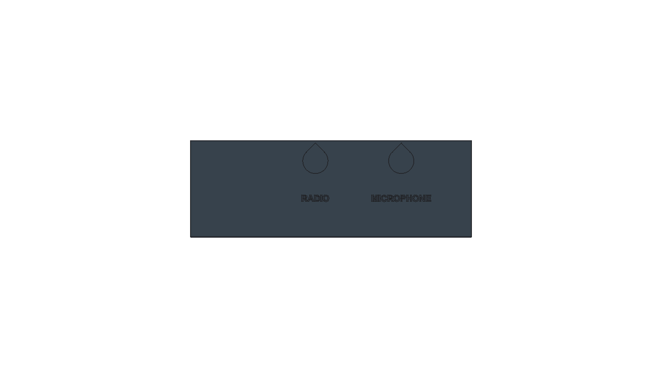
docs/verification/enclosure-p0/rear-labels.png
