kyleburnsdev/icom-ctcss-board/docs/verification/enclosure-p0/slice-01-fit-coupons.png

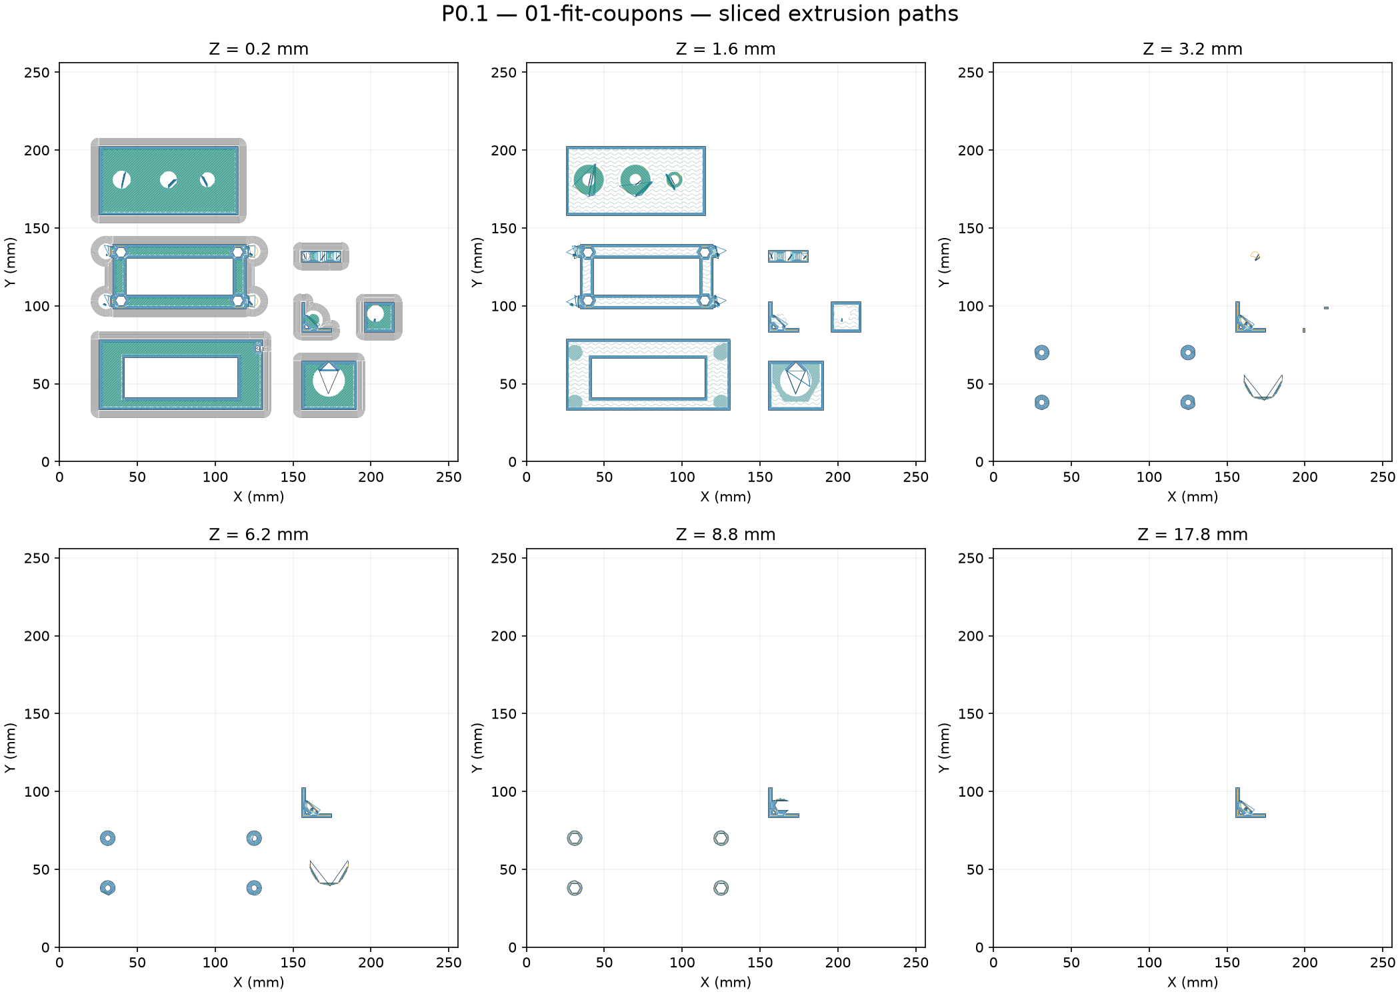
docs/verification/enclosure-p0/slice-01-fit-coupons.png
