kyleburnsdev/icom-ctcss-board/docs/verification/enclosure-p0/slice-02-base.png

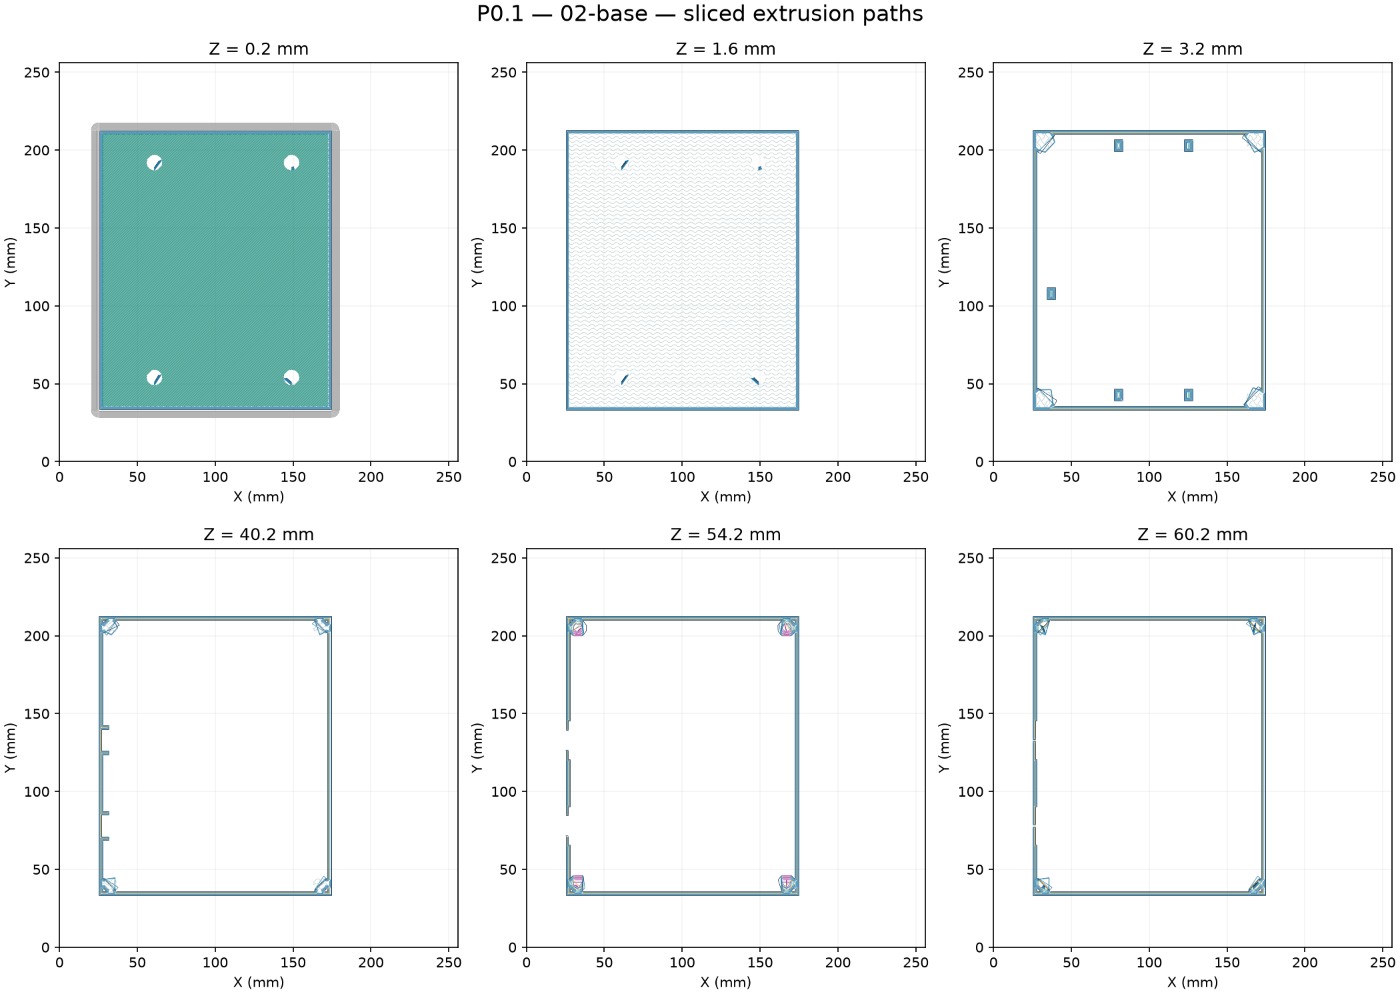
docs/verification/enclosure-p0/slice-02-base.png
