kyleburnsdev/icom-ctcss-board/docs/verification/enclosure-p0/slice-03-lid-and-retainers.png

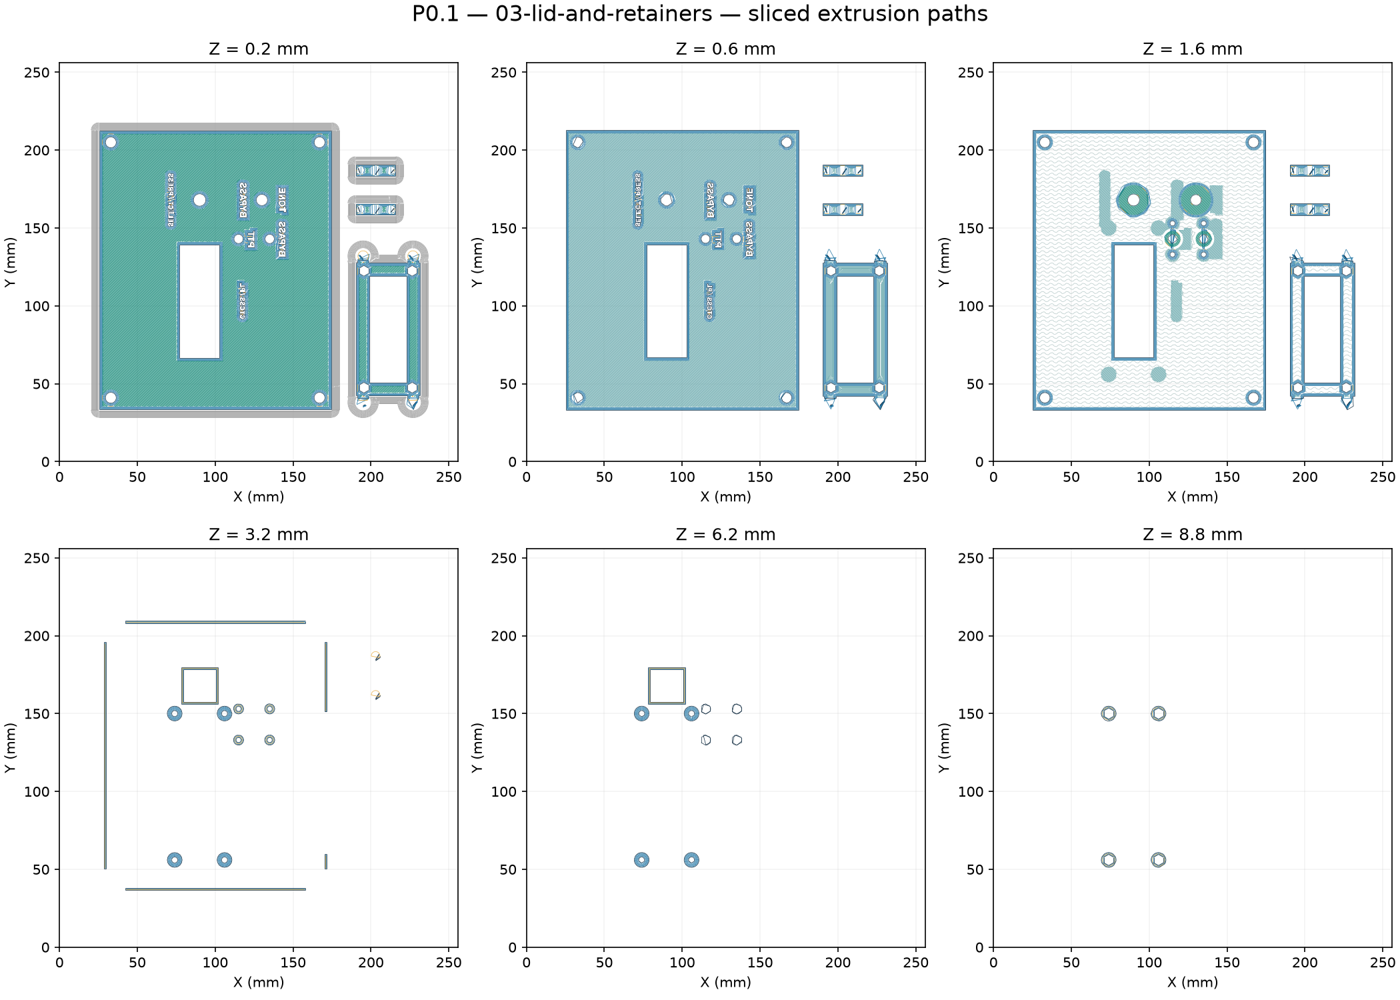
docs/verification/enclosure-p0/slice-03-lid-and-retainers.png
