kyleburnsdev/icom-ctcss-board/docs/verification/enclosure-p1/base-interior.png

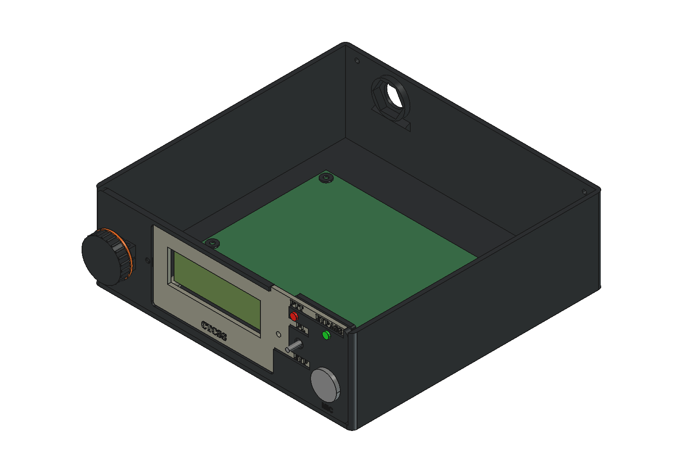
docs/verification/enclosure-p1/base-interior.png
