kyleburnsdev/icom-ctcss-board/docs/verification/enclosure-p1/fascia-rear.png

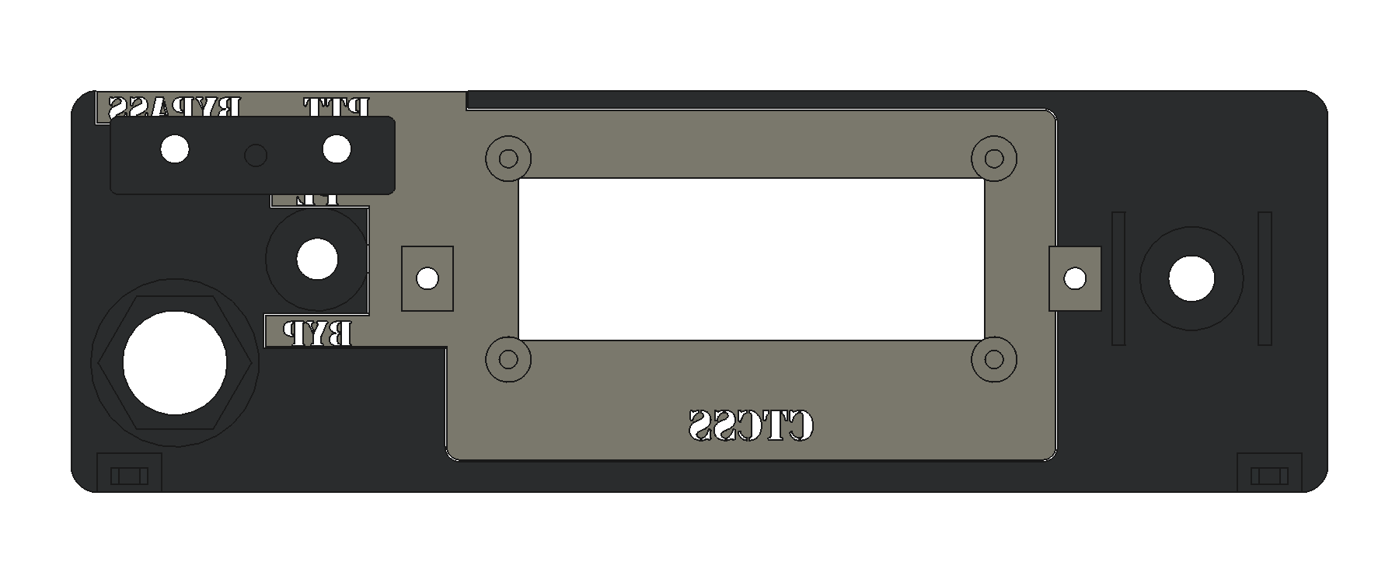
docs/verification/enclosure-p1/fascia-rear.png
