kyleburnsdev/icom-ctcss-board/docs/verification/enclosure-p1/slice-01-fascia-and-fit-coupons.png

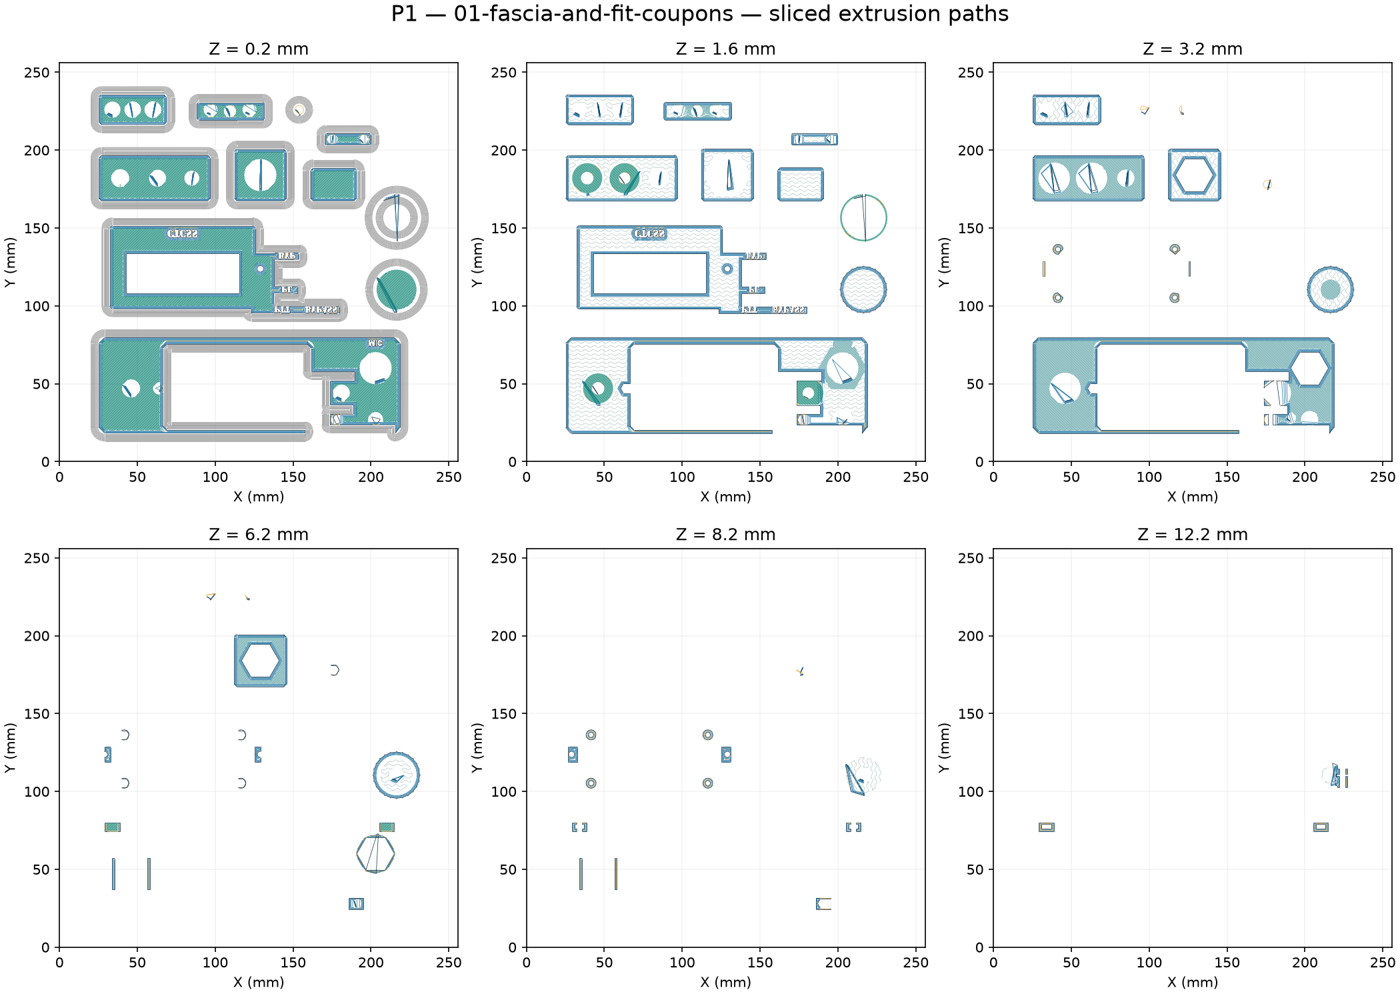
docs/verification/enclosure-p1/slice-01-fascia-and-fit-coupons.png
