kyleburnsdev/icom-ctcss-board/docs/verification/enclosure-p1/slice-02-base-and-retainers.png

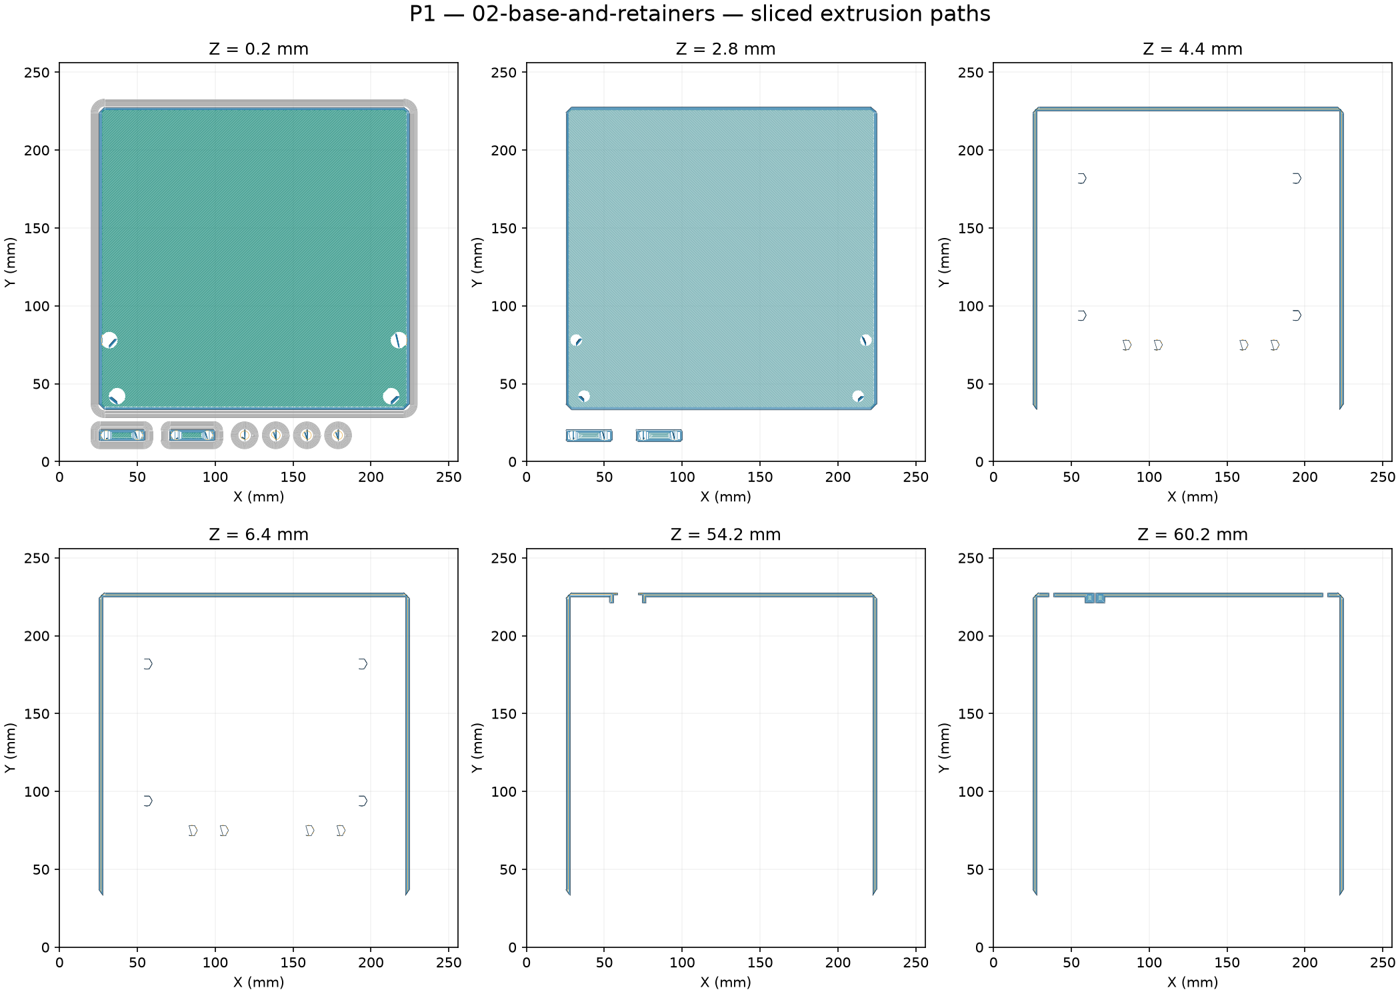
docs/verification/enclosure-p1/slice-02-base-and-retainers.png
