kyleburnsdev/icom-ctcss-board/docs/verification/enclosure-p1/slice-03-cover.png

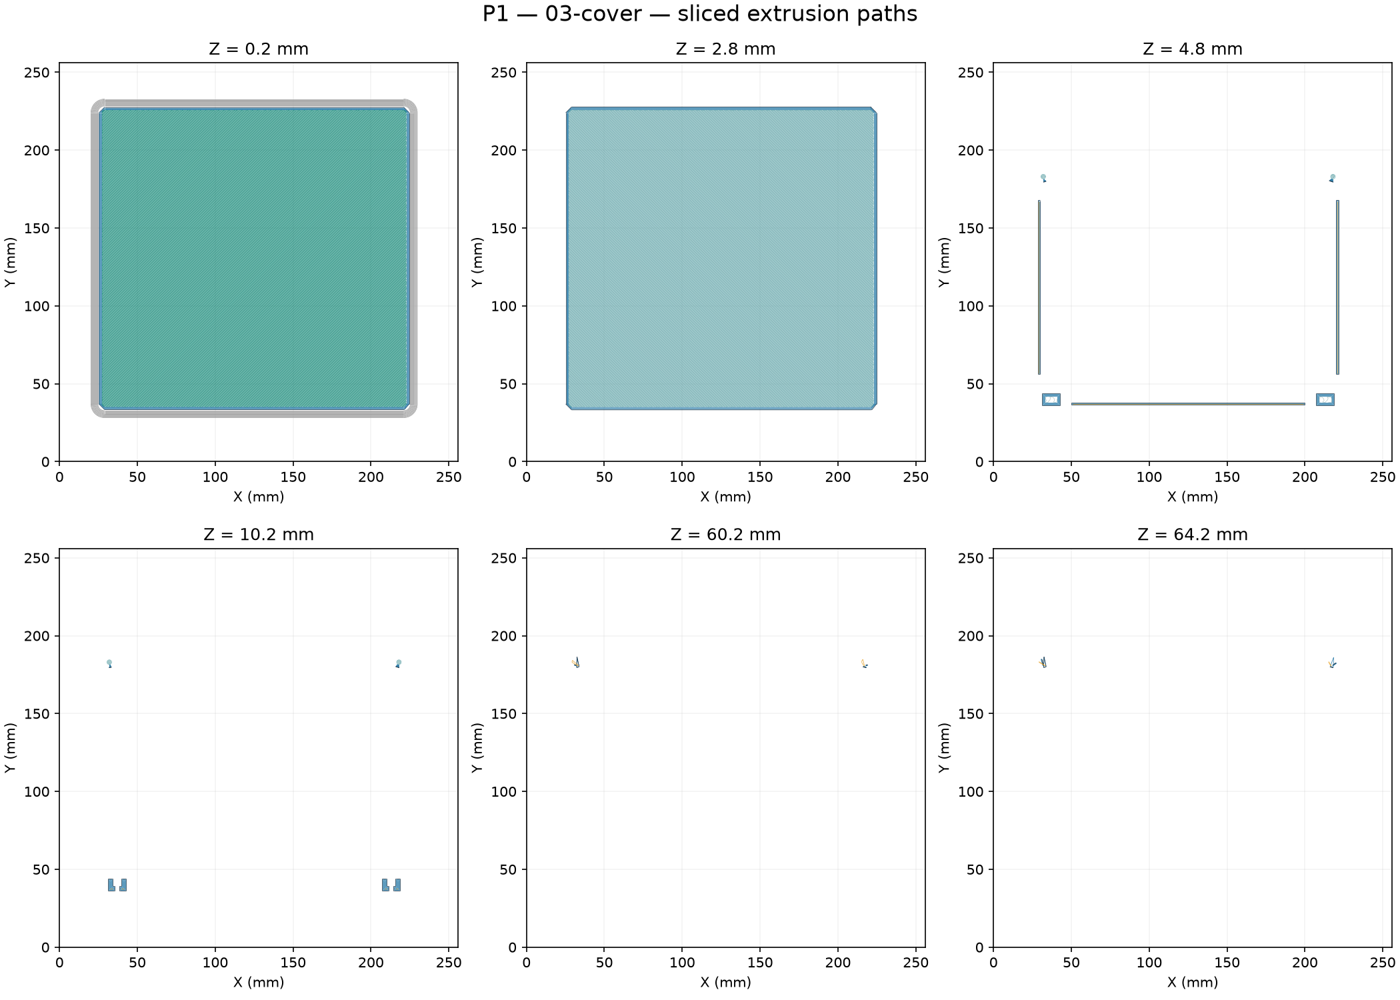
docs/verification/enclosure-p1/slice-03-cover.png
