kyleburnsdev/icom-ctcss-board/docs/verification/pcb-cam-bottom.png

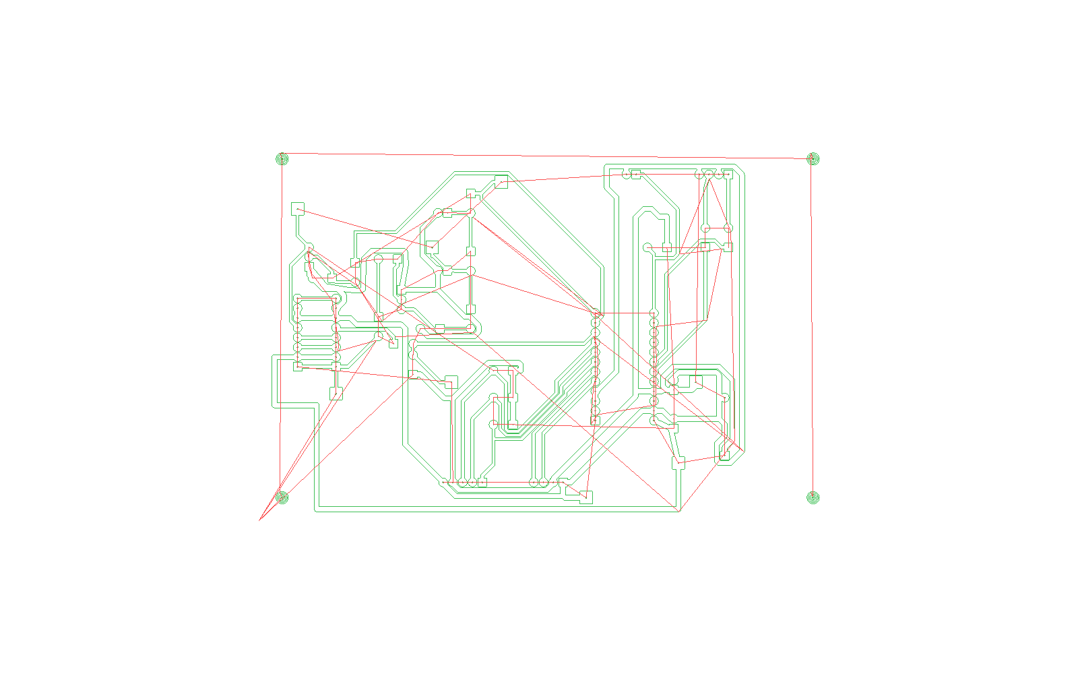
docs/verification/pcb-cam-bottom.png
