kyleburnsdev/icom-ctcss-board/docs/verification/pcb-mask-paths.png

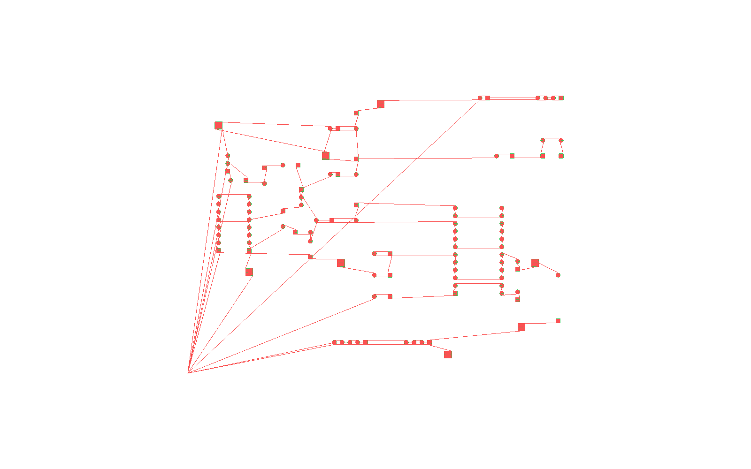
docs/verification/pcb-mask-paths.png
