kyleburnsdev/icom-ctcss-board/manufacturing/enclosure/supporting/revisions/p01/README.md

# P0.1 historical build

This directory preserves the previous three-plate project and its supporting exports. Use the [current P1 build](../../../README.md) for the current enclosure.

The [historical design record](../../../../../docs/implementation/enclosure-p0.md) and [native P0.1 CAD](../../../../../mechanical/enclosure/revisions/p01-enclosure.FCStd) describe this revision. These assets do not validate P1.
