kyleburnsdev/icom-ctcss-board/manufacturing/pcb/carvera-air/print-masks/top-legend-negative-100x150mm.pdf

## TOP LEGEND / NEGATIVE MASK

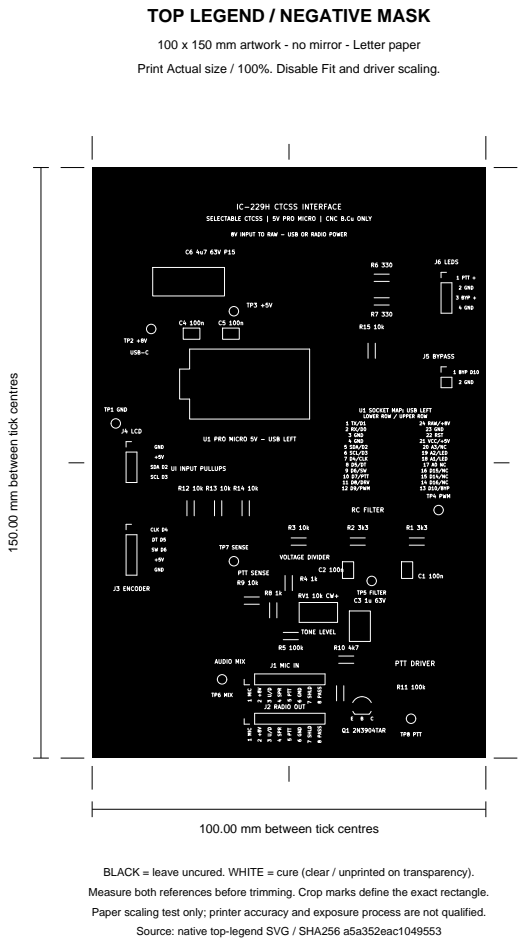
[picture p53: page 1]

100 x 150 mm artwork - no mirror - Letter paper
Print Actual size / 100%. Disable Fit and driver scaling.

150.00 mm between tick centres

100.00 mm between tick centres

BLACK = leave uncured. WHITE = cure (clear / unprinted on transparency).
Measure both references before trimming. Crop marks define the exact rectangle.
Paper scaling test only; printer accuracy and exposure process are not qualified.

Source: native top-legend SVG / SHA256 a5a352eac1049553
