kyleburnsdev/icom-ctcss-board/docs/verification/ltspice/tone-ac.cir

* Nominal transfer per volt of PWM AC fundamental, not 5V logic swing
.include nominal.inc
Vdrive pwm 0 DC 2.5 AC 1
.include tone-network.inc
Rload audio 0 {RL}
.options numdgt=16
.step param RL list 600 1k 2.2k 10k 100k
.step param W list 0 .25 .5 .75 1
.ac list 67 69.3 71.9 74.4 77 79.7 82.5 85.4 88.5 91.5 94.8 97.4 100 103.5 107.2 110.9 114.8 118.8 123 127.3 131.8 136.5 141.3 146.2 151.4 156.7 159.8 162.2 165.5 167.9 171.3 173.8 177.3 179.9 183.5 186.2 189.9 192.8 196.6 199.5 203.5 206.5 210.7 218.1 225.7 229.1 233.6 241.8 250.3 254.1 10000
.save V(audio) V(filter2) V(divider) V(wiper)
.end
