kyleburnsdev/icom-ctcss-board/(list of files, drawings)

Other design files:
docs/verification/pcb-cam-geometry.json
docs/verification/pcb-cam-job-split.json
docs/verification/pcb-cam-jobs.json
docs/verification/pcb-cam-reopen.json
docs/verification/pcb-keepout-fill.json
docs/verification/pcb-mask-job.json
docs/verification/pcb-native-update.json
docs/verification/pcb-posted-motion.json
docs/verification/pcb-revision.json
