kyleburnsdev/icom-ctcss-board/electronics/icom-ctcss-board.kicad_pcb

## KiCad design electronics/icom-ctcss-board.kicad_pcb (2026-10-31)

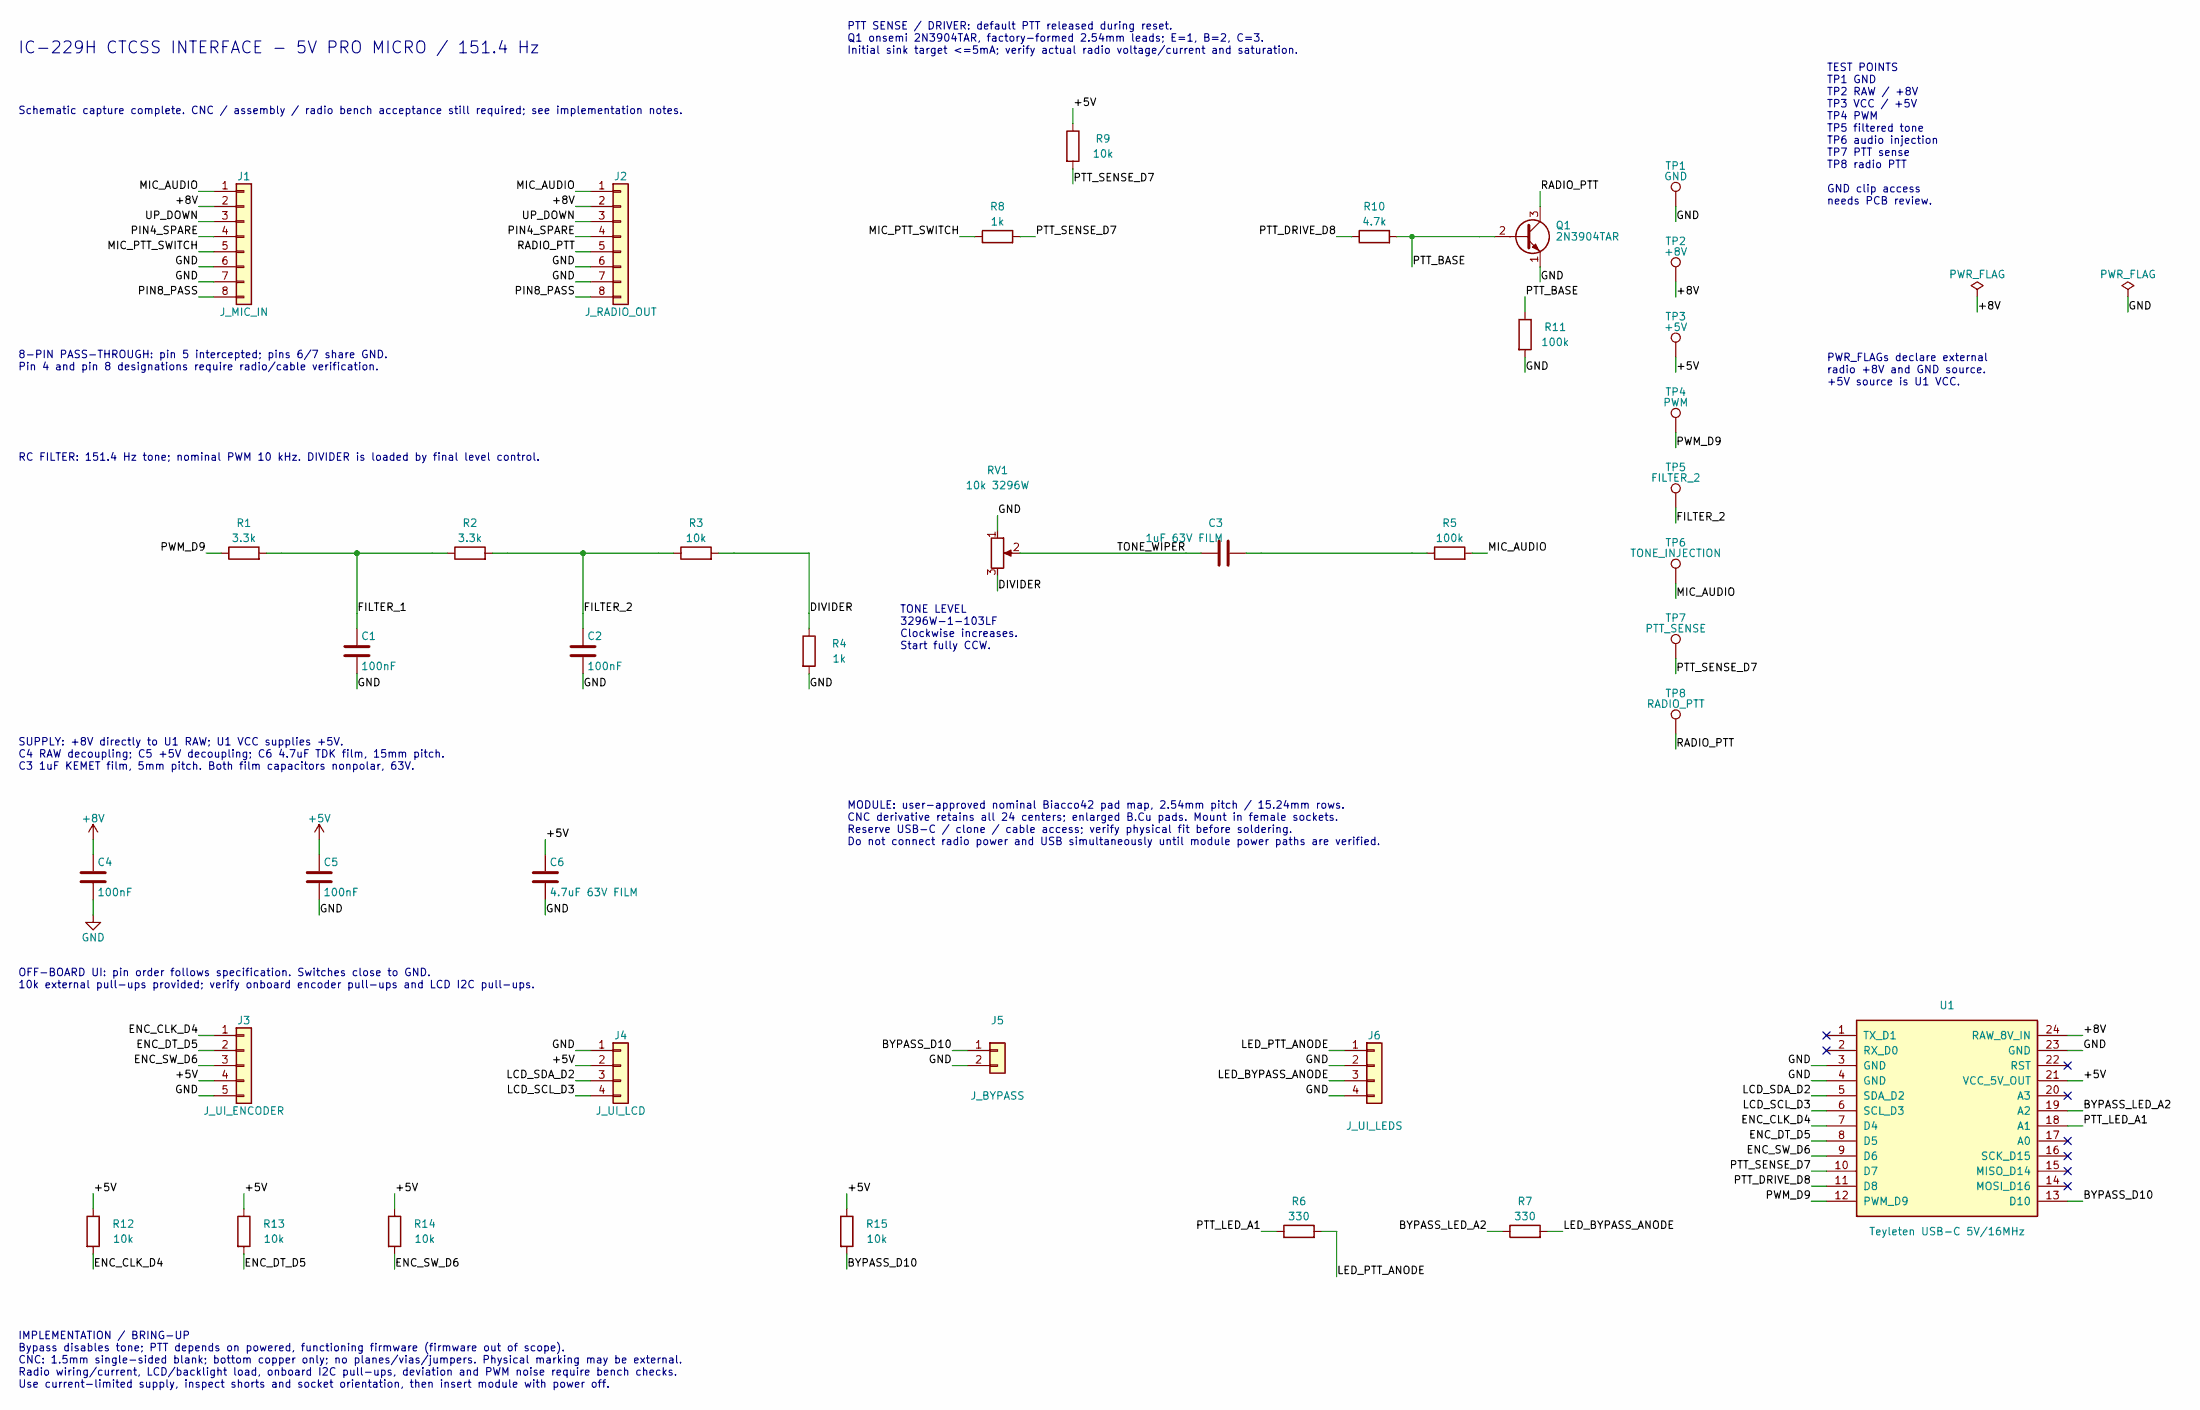
[picture p54: schematic icom-ctcss-board.kicad_sch]

Parts:
C1, C2, C4, C5: 100nF; C_Disc_P2.5_CNC; MPN K104K15X7RF5TL2
C3: 1uF 63V FILM; C_Film1u_P5_CNC; MPN R82DC4100AA60J
C6: 4.7uF 63V FILM; C_Film4u7_P15_CNC; MPN B32522C0475J000
J1: J_MIC_IN; Header_1x08_CNC; MPN 61300811121
J2: J_RADIO_OUT; Header_1x08_CNC; MPN 61300811121
J3: J_UI_ENCODER; Header_1x05_CNC; MPN 61300511121
J4: J_UI_LCD; Header_1x04_CNC; MPN 61300411121
J5: J_BYPASS; Header_1x02_CNC; MPN 61300211121
J6: J_UI_LEDS; Header_1x04_CNC; MPN 61300411121
Q1: 2N3904TAR; Q_TO92_Formed_CNC; MPN 2N3904TAR
R1, R2: 3.3k; R_P5.08_CNC; MPN MRS16000C3301FCT00
R3, R9, R12, R13, R14, R15: 10k; R_P5.08_CNC; MPN MRS16000C1002FCT00
R4, R8: 1k; R_P5.08_CNC; MPN MRS16000C1001FCT00
R5, R11: 100k; R_P5.08_CNC; MPN MRS16000C1003FCT00
R6, R7: 330; R_P5.08_CNC; MPN MRS16000C3300FCT00
R10: 4.7k; R_P5.08_CNC; MPN MRS16000C4701FCT00
RV1: 10k 3296W; RV_3296W_CNC; MPN 3296W-1-103LF
TP1: GND; TP_CNC; MPN 61300111121
TP2: +8V; TP_CNC; MPN 61300111121
TP3: +5V; TP_CNC; MPN 61300111121
TP4: PWM; TP_CNC; MPN 61300111121
TP5: FILTER_2; TP_CNC; MPN 61300111121
TP6: TONE_INJECTION; TP_CNC; MPN 61300111121
TP7: PTT_SENSE; TP_CNC; MPN 61300111121
TP8: RADIO_PTT; TP_CNC; MPN 61300111121
U1: Teyleten USB-C 5V/16MHz; ProMicro_CNC_BCu; MPN USB-C Pro Micro 5V 16MHz

Connections:
+5V: C5.1, C6.1, J3.4, J4.2, R9.1, R12.1, R13.1, R14.1, R15.1, TP3.1, U1.21 (VCC_5V_OUT)
+8V: C4.1, J1.2, J2.2, TP2.1, U1.24 (RAW_8V_IN)
/BYPASS_D10: J5.1, R15.2, U1.13 (D10)
/BYPASS_LED_A2: R7.1, U1.19 (A2)
/DIVIDER: R3.2, R4.1, RV1.3
/ENC_CLK_D4: J3.1, R12.2, U1.7 (D4)
/ENC_DT_D5: J3.2, R13.2, U1.8 (D5)
/ENC_SW_D6: J3.3, R14.2, U1.9 (D6)
/FILTER_1: C1.1, R1.2, R2.1
/FILTER_2: C2.1, R2.2, R3.1, TP5.1
/LCD_SCL_D3: J4.4, U1.6 (SCL_D3)
/LCD_SDA_D2: J4.3, U1.5 (SDA_D2)
/LED_BYPASS_ANODE: J6.3, R7.2
/LED_PTT_ANODE: J6.1, R6.2
/MIC_AUDIO: J1.1, J2.1, R5.2, TP6.1
/MIC_PTT_SWITCH: J1.5, R8.1
/PIN4_SPARE: J1.4, J2.4
/PIN8_PASS: J1.8, J2.8
/PTT_BASE: Q1.2 (B), R10.2, R11.1
/PTT_DRIVE_D8: R10.1, U1.11 (D8)
/PTT_LED_A1: R6.1, U1.18 (A1)
/PTT_SENSE_D7: R8.2, R9.2, TP7.1, U1.10 (D7)
/PWM_D9: R1.1, TP4.1, U1.12 (PWM_D9)
/RADIO_PTT: J2.5, Q1.3 (C), TP8.1
/TONE_WIPER: C3.1, RV1.2
/UP_DOWN: J1.3, J2.3
GND: C1.2, C2.2, C4.2, C5.2, C6.2, J1.6, J1.7, J2.6, J2.7, J3.5, J4.1, J5.2, J6.2, J6.4, Q1.1 (E), R4.2, R11.2, RV1.1, TP1.1, U1.3 (GND), U1.4 (GND), U1.23 (GND)
unnamed: C3.2, R5.1

Notes on the sheet:
8-PIN PASS-THROUGH: pin 5 intercepted; pins 6/7 share GND. Pin 4 and pin 8 designations require radio/cable verification.
RC FILTER: 151.4 Hz tone; nominal PWM 10 kHz. DIVIDER is loaded by final level control.
OFF-BOARD UI: pin order follows specification. Switches close to GND. 10k external pull-ups provided; verify onboard encoder pull-ups and LCD I2C pull-ups.
TEST POINTS TP1 GND TP2 RAW / +8V TP3 VCC / +5V TP4 PWM TP5 filtered tone TP6 audio injection TP7 PTT sense TP8 radio PTT GND clip access needs PCB review.
IC-229H CTCSS INTERFACE - 5V PRO MICRO / 151.4 Hz
Schematic capture complete. CNC / assembly / radio bench acceptance still required; see implementation notes.
TONE LEVEL 3296W-1-103LF Clockwise increases. Start fully CCW.
MODULE: user-approved nominal Biacco42 pad map, 2.54mm pitch / 15.24mm rows. CNC derivative retains all 24 centers; enlarged B.Cu pads. Mount in female sockets. Reserve USB-C / clone / cable access; verify physical fit before soldering. Do not connect radio power and USB simultaneously until module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
IMPLEMENTATION / BRING-UP Bypass disables tone; PTT depends on powered, functioning firmware (firmware out of scope). CNC: 1.5mm single-sided blank; bottom copper only; no planes/vias/jumpers. Physical marking may be external. Radio wiring/current, LCD/backlight load, onboard I2C pull-ups, deviatio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
PWR_FLAGs declare external radio +8V and GND source. +5V source is U1 VCC.
PTT SENSE / DRIVER: default PTT released during reset. Q1 onsemi 2N3904TAR, factory-formed 2.54mm leads; E=1, B=2, C=3. Initial sink target <=5mA; verify actual radio voltage/current and saturation.
SUPPLY: +8V directly to U1 RAW; U1 VCC supplies +5V. C4 RAW decoupling; C5 +5V decoupling; C6 4.7uF TDK film, 15mm pitch. C3 1uF KEMET film, 5mm pitch. Both film capacitors nonpolar, 63V.

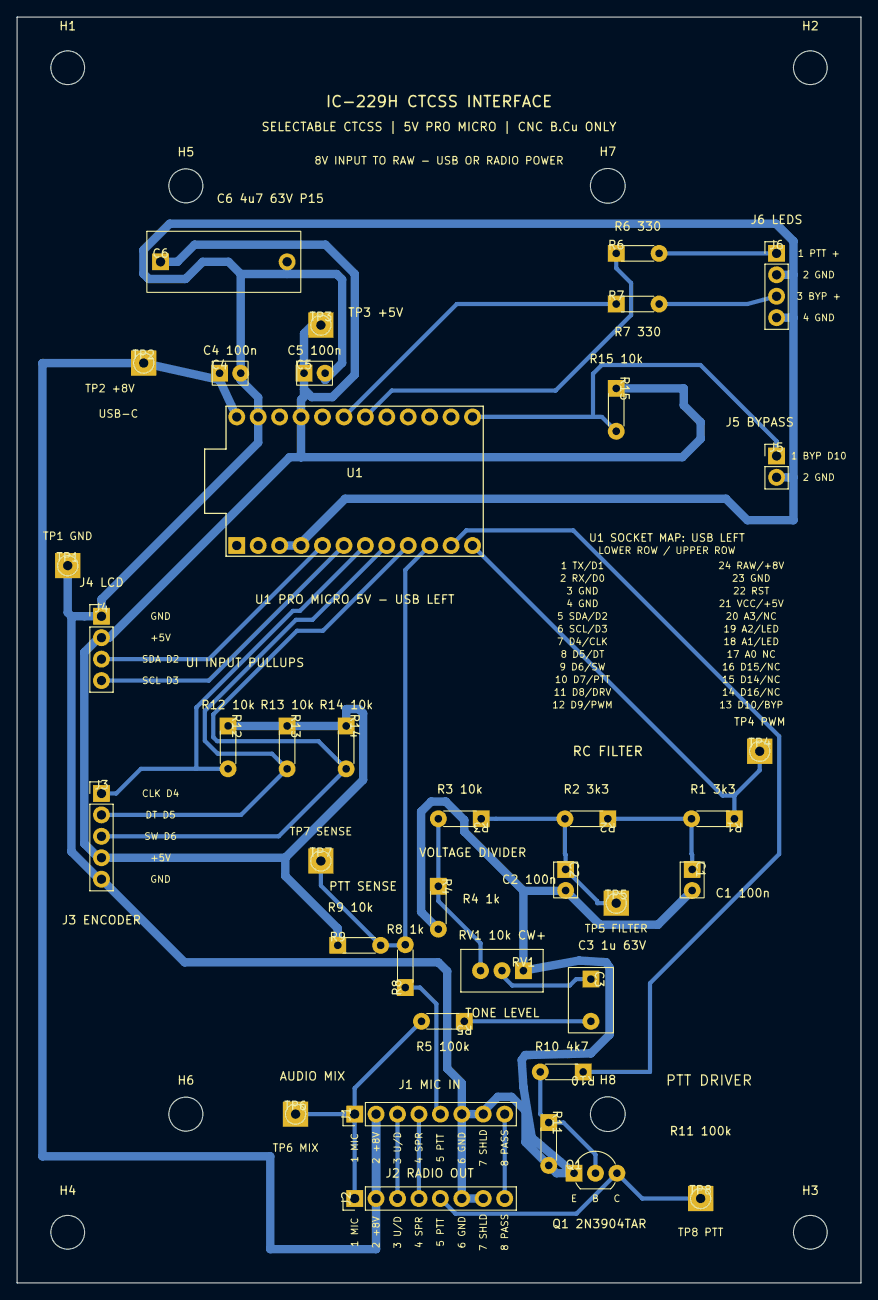
[picture p55: board icom-ctcss-board.kicad_pcb from above]

Board: 2 copper layers, 100.0 x 150.0 mm, 46 parts (0 on the bottom side), 28 nets.

Other parts of the board:
H1, H2, H3, H4: MountingHole_4mm
H5, H6: JigRegistration_4.03mm
H7, H8: JigRegistration_4.12mm
