kyleburnsdev/icom-ctcss-board/(commit log)

2026-10-21 Initial public release of CTCSS interface hardware and documentation
    [bom.csv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]
2026-10-22 PCB fabrication guide
2026-10-22 updates due to parts availability
    [bom.csv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]
2026-10-22 initial enclosure work
    [icom-ctcss-enclosure.FCStd, p0-base.stl, p0-controlcoupon.stl, p0-enclosure-assembly.step, p0-gxcoupon.stl, p0-jointbasecoupon.stl, p0-jointlidcoupon.stl, p0-lcdcoupon.stl]
2026-10-31 incorporates new jig
    [board-outline.gm1, bottom-copper-Y-FLIPPED.gbl, bottom-electrical-holes-Y-FLIPPED.drl, icom-ctcss-board-B_Cu.gbl, icom-ctcss-board-Edge_Cuts.gm1, icom-ctcss-board-F_Silkscreen.gto, icom-ctcss-board-NPTH.drl, icom-ctcss-board-PTH.drl]
2026-11-01 Add PCB fabrication guide, negative legend mask, and DigiKey parts list
    [digikey-board-parts.csv]
